Traiserdinger/Custom-PX4-Flight-Controller/Hardware/Project Outputs for Trung Flight Controller/Net Status - Trung PX4 Flight Controller PCB.html

Altium customize

# Net Status Report

Date: | | 16/08/2026
Time: | | 5:39:50 CH
Elapsed Time: | | 00:00:00
Filename: | | C:\Users\Public\Documents\Altium\Projects\PX4 Flight Controller\Trung PX4 Flight Controller PCB.PcbDoc
Units: | | mmmils

Nets | Layer | Length
+3.3 | Signal Layers Only | 237.2458mm
+5 | Signal Layers Only | 95.8072mm
5V_SERVO | Signal Layers Only | 0mm
AUX_OUT_1 | Signal Layers Only | 0mm
AUX_OUT_2 | Signal Layers Only | 0mm
AUX_OUT_3 | Signal Layers Only | 0mm
AUX_OUT_4 | Signal Layers Only | 0mm
AUX_PWM_1 | Signal Layers Only | 10.7949mm
AUX_PWM_2 | Signal Layers Only | 8.8497mm
AUX_PWM_3 | Signal Layers Only | 6.9821mm
AUX_PWM_4 | Signal Layers Only | 6.4275mm
BARO1_CS | Signal Layers Only | 28.2336mm
BARO2_CS | Signal Layers Only | 19.96mm
BATT_CURRENT_SENS | Signal Layers Only | 0mm
BATT_VOLTAGE_SENS | Signal Layers Only | 0mm
BUZZER | Signal Layers Only | 82.9503mm
CAN1_RX | Signal Layers Only | 6.7935mm
CAN1_TX | Signal Layers Only | 3.9007mm
CAN2_TX | Signal Layers Only | 0mm
CAN_N | Signal Layers Only | 80.7832mm
CAN_P | Signal Layers Only | 80.543mm
FMU-SWCLK | Signal Layers Only | 152.9089mm
FMU-SWDIO | Signal Layers Only | 130.2979mm
FMU_USART6_RX | Signal Layers Only | 17.5303mm
FMU_USART6_TX | Signal Layers Only | 0mm
FPGA_CS | Signal Layers Only | 46.5756mm
FPGA_SPI_MISO | Signal Layers Only | 51.7681mm
FPGA_SPI_MOSI | Signal Layers Only | 48.0146mm
FPGA_SPI_SCK | Signal Layers Only | 55.9898mm
FRAM_CS | Signal Layers Only | 10.7605mm
GND | Signal Layers Only | 0mm
I2C1_SCL | Signal Layers Only | 44.911mm
I2C1_SDA | Signal Layers Only | 44.6991mm
I2C2_SCL | Signal Layers Only | 65.9293mm
I2C2_SDA | Signal Layers Only | 62.0535mm
IBUS_SIGNAL | Signal Layers Only | 7.2247mm
IMU1_CS | Signal Layers Only | 11.66mm
IMU1_DRDY | Signal Layers Only | 41.7434mm
IMU2_CS | Signal Layers Only | 39.8278mm
IMU2_DRDY | Signal Layers Only | 40.4862mm
LED1_STATUS | Signal Layers Only | 50.241mm
LED2_STATUS | Signal Layers Only | 56.7658mm
MOTOR_1 | Signal Layers Only | 22.9411mm
MOTOR_2 | Signal Layers Only | 22.2621mm
MOTOR_3 | Signal Layers Only | 19.4496mm
MOTOR_4 | Signal Layers Only | 16.6951mm
NetC29_2 | Signal Layers Only | 1.9167mm
NetC39_2 | Signal Layers Only | 6.6173mm
NetC40_2 | Signal Layers Only | 2.2543mm
NetC5_2 | Signal Layers Only | 5.5239mm
NetC6_2 | Signal Layers Only | 4.3707mm
NetC9_1 | Signal Layers Only | 1.9088mm
NetD1_A | Signal Layers Only | 1.6719mm
NetD2_A | Signal Layers Only | 1.6095mm
NetD4_C | Signal Layers Only | 1.6189mm
NetD6_C | Signal Layers Only | 1.6178mm
NetD7_C | Signal Layers Only | 1.642mm
NetJ1_A5 | Signal Layers Only | 4.2391mm
NetJ1_B5 | Signal Layers Only | 4.2736mm
NetJ2_P1 | Signal Layers Only | 5.2159mm
NetP1_1 | Signal Layers Only | 9.8137mm
NetP1_2 | Signal Layers Only | 7.2868mm
NetP1_3 | Signal Layers Only | 6.872mm
NetP1_5 | Signal Layers Only | 6.2762mm
NetP1_7 | Signal Layers Only | 7.3289mm
NetP1_8 | Signal Layers Only | 10.278mm
NetQ1_1 | Signal Layers Only | 1.8466mm
NetR1_1 | Signal Layers Only | 16.2939mm
NetR33_1 | Signal Layers Only | 2.2852mm
OTG_FS_N | Signal Layers Only | 18.1629mm
OTG_FS_P | Signal Layers Only | 16.5977mm
OUT_1 | Signal Layers Only | 44.5039mm
OUT_2 | Signal Layers Only | 55.2337mm
OUT_3 | Signal Layers Only | 51.2503mm
OUT_4 | Signal Layers Only | 38.8108mm
OUT_5 | Signal Layers Only | 0mm
OUT_6 | Signal Layers Only | 0mm
PB2-BOOT1 | Signal Layers Only | 4.2311mm
PC14 | Signal Layers Only | 14.3922mm
PC15 | Signal Layers Only | 10.0584mm
PH0 | Signal Layers Only | 2.6934mm
PH1 | Signal Layers Only | 3.5003mm
RESET | Signal Layers Only | 69.2586mm
SAFETY_LED | Signal Layers Only | 56.8271mm
SAFETY_SWITCH | Signal Layers Only | 46.5075mm
SDMMC_CLK | Signal Layers Only | 75.1902mm
SDMMC_CMD | Signal Layers Only | 116.0412mm
SDMMC_D0 | Signal Layers Only | 62.3294mm
SDMMC_D1 | Signal Layers Only | 65.6951mm
SDMMC_D2 | Signal Layers Only | 79.0215mm
SDMMC_D3 | Signal Layers Only | 77.6269mm
SD_CD | Signal Layers Only | 2.4243mm
SPI1_MISO | Signal Layers Only | 37.963mm
SPI1_MOSI | Signal Layers Only | 60.3726mm
SPI1_SCK | Signal Layers Only | 61.905mm
SPI2_MISO | Signal Layers Only | 8.4154mm
SPI2_MOSI | Signal Layers Only | 13.3209mm
SPI2_SCK | Signal Layers Only | 16.4157mm
SPI3_MISO | Signal Layers Only | 2.7848mm
SPI3_MOSI | Signal Layers Only | 2.7338mm
SPI3_SCK | Signal Layers Only | 14.4717mm
UART4_RX | Signal Layers Only | 28.0332mm
UART4_TX | Signal Layers Only | 36.4451mm
UART7_RX | Signal Layers Only | 32.0728mm
UART7_TX | Signal Layers Only | 42.638mm
UART8_RX | Signal Layers Only | 96.581mm
UART8_TX | Signal Layers Only | 87.9697mm
USART2_RX | Signal Layers Only | 0mm
USART2_TX | Signal Layers Only | 0mm
USART3_RX | Signal Layers Only | 0mm
USART3_TX | Signal Layers Only | 0mm
USB_CONN_N | Signal Layers Only | 10.9234mm
USB_CONN_P | Signal Layers Only | 14.1718mm
VADC | Signal Layers Only | 9.8255mm
VBAT_IN | Signal Layers Only | 88.3314mm
VBUS | Signal Layers Only | 58.5316mm
VCC_3V3_SENS | Signal Layers Only | 88.0643mm

Back to top
