Traiserdinger/Custom-PX4-Flight-Controller/Docs/images/pcb_bot.jpg

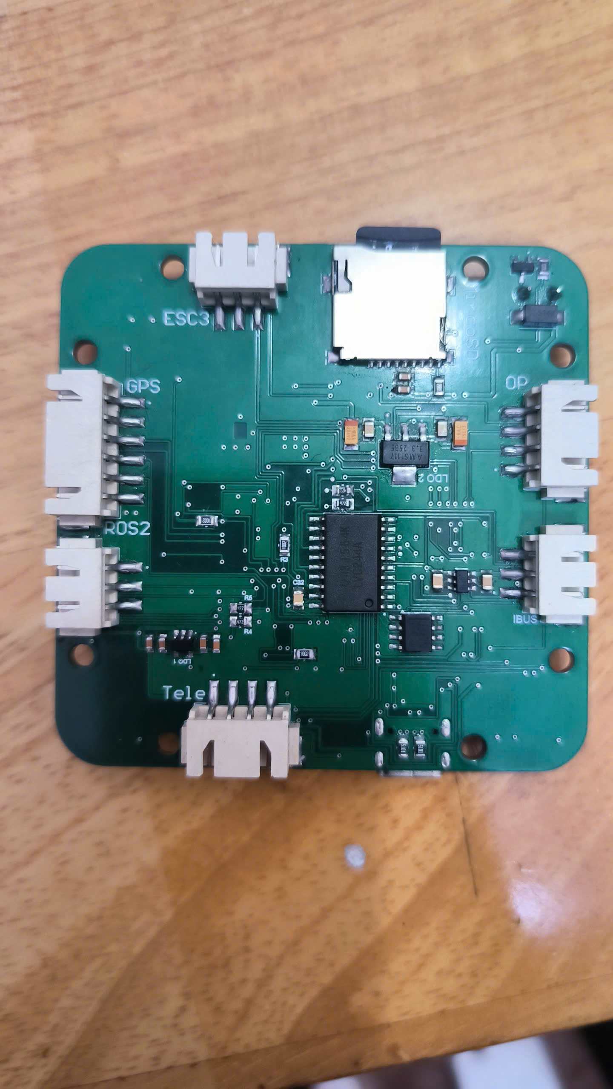
Docs/images/pcb_bot.jpg
