Traiserdinger/Custom-PX4-Flight-Controller/Docs/images/pcb_top.jpg

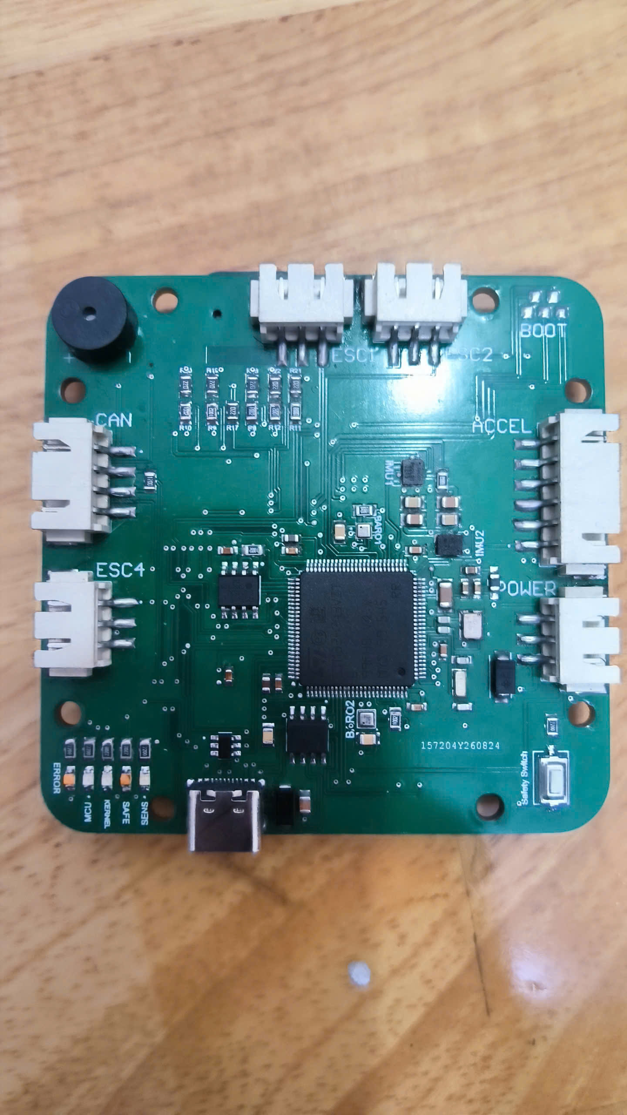
Docs/images/pcb_top.jpg
