Traiserdinger/Custom-PX4-Flight-Controller/Hardware/Project Outputs for Trung Flight Controller/Trung_Flight_Controller_BOM.xlsx

Comment | Description | Designator | Kích thước | LibRef | Quantity | Tình trạng | Giá thành | Nhà cung cấp
FPGA Accel | Đầu nối JST XH 6 chân, hàn SMD, góc vuông | ACCEL | Pitch 2.5mm, 6 chân | S6B-XH-SM4-TB | 1 | Chưa tìm được
BMP390L | Cảm biến áp suất tuyệt đối 30–125kPa, dùng đo độ cao | BARO1 | 10-WFLGA, ~2.0 x 2.0 x 0.8mm | BMP390L | 1 | Chưa tìm được
BMP581 | Cảm biến áp suất khí quyển 24-bit, công suất thấp, độ nhiễu thấp, dùng đo độ cao | BARO2 | LGA, ~2.0 x 2.0 x 0.75mm | BMP581 | 1 | Chưa tìm được
Pad Connector | Chân pad hàn trên PCB dùng để boot | BOOT | Pad hàn trên PCB | Pad Connector | 1 | Chưa tìm được
100nF | Tụ gốm SMD X7R ±10%, 50V | C1, C2, C3, C4, C7, C10, C20, C21, C22, C23, C30 | 0603 (1.6 x 0.8mm) | GRM188R71H104KA93D | 11 | Chưa tìm được
2.2uF | Tụ gốm SMD X7R ±10%, 50V | C5, C6 | 0603 (1.6 x 0.8mm) | GRM188R71H104KA93D | 2 | Chưa tìm được
100nF | Tụ gốm SMD X7R ±10%, 100V | C8 | 1206 (3.2 x 1.6mm) | 12061C104KAT2A | 1 | Chưa tìm được
1uF | Tụ gốm SMD X7R ±10%, 50V | C9, C11, C28, C31 | 0603 (1.6 x 0.8mm) | GRM188R71H104KA93D | 4 | Chưa tìm được
10pF | Tụ gốm SMD X7R ±10%, 50V | C12, C13 | 0603 (1.6 x 0.8mm) | GRM188R71H104KA93D | 2 | Chưa tìm được
100nF | Tụ gốm SMD X7R ±10%, 50V | C14, C15, C16, C18, C25, C26, C32, C33, C34, C36 | 0805 (2.0 x 1.2mm) | GRM21BR71H104KA01L | 10 | Chưa tìm được
2.2uF | Tụ gốm SMD X7R 2.2µF ±10%, 25V | C17, C19 | 0805 (2.0 x 1.2mm) | 08053C225K4Z2A | 2 | Chưa tìm được
10uF | Tụ tantalum 10µF, 10V, ESR 3.8Ω | C24, C27 | 1206 (3.2 x 1.6mm) | T491A106K010AT7280 | 2 | Chưa tìm được
22nF | Tụ gốm SMD X7R ±10%, 50V | C29 | 0603 (1.6 x 0.8mm) | GRM188R71H104KA93D | 1 | Chưa tìm được
10uF | Tụ gốm SMD X5R 10µF ±10%, 16V | C35 | 0805 (2.0 x 1.2mm) | GRM21BR61C106KE15L | 1 | Chưa tìm được
8pF | Tụ gốm SMD C0G/NP0 8pF ±0.5pF, 50V | C39, C40 | 0402 (1.0 x 0.5mm) | C1005C0G1H080D050BA | 2 | Chưa tìm được
CAN | Đầu nối JST XH 4 chân, hàn SMD, góc vuông | CAN | Pitch 2.5mm, 4 chân | S4B-XH-SM4-TB | 1 | Chưa tìm được
SS34L | Diode Schottky 3A, 40V, dạng phẳng (planar) | D3 | SOD-123FL, ~3.6 x 1.8mm | SS34L | 1 | Chưa tìm được
SMAJ5.0A | Diode bảo vệ TVS 5.0V, 400W, 1 chiều | D5 | SMA (DO-214AC), ~5.0 x 2.6mm | SMAJ5.0A | 1 | Chưa tìm được
Error LED | LED đỏ 633nm, 2.1V | ERROR | 0805 (2.0 x 1.25mm) | 5990110007F | 1 | Chưa tìm được
ESC1 | Đầu nối JST XH 3 chân, hàn SMD, góc vuông | ESC1 | Pitch 2.5mm, 3 chân | S3B-XH-SM3-TB | 1 | Chưa tìm được
ESC2 | Đầu nối JST XH 3 chân, hàn SMD, góc vuông | ESC2 | Pitch 2.5mm, 3 chân | S3B-XH-SM3-TB | 1 | Chưa tìm được
ESC3 | Đầu nối JST XH 3 chân, hàn SMD, góc vuông | ESC3 | Pitch 2.5mm, 3 chân | S3B-XH-SM3-TB | 1 | Chưa tìm được
ESC4 | Đầu nối JST XH 3 chân, hàn SMD, góc vuông | ESC4 | Pitch 2.5mm, 3 chân | S3B-XH-SM3-TB | 1 | Chưa tìm được
600 | Cuộn ferrite bead 560Ω | FB1 | 0805 (2.0 x 1.2mm) | WE-CBA_0805 | 1 | Chưa tìm được
GPS | Đầu nối JST XH 6 chân, hàn SMD, góc vuông | GPS | Pitch 2.5mm, 6 chân | S6B-XH-SM4-TB | 1 | Chưa tìm được
iA6B i-Bus | Đầu nối JST XH 3 chân, hàn SMD, góc vuông | IBUS | Pitch 2.5mm, 3 chân | S3B-XH-SM3-TB | 1 | Chưa tìm được
ICM-42670-P | Cảm biến IMU 6 trục (gia tốc + con quay hồi chuyển) | IMU1 | QFN, xem datasheet | ICM-42670-P | 1 | Chưa tìm được
ICM-42688-P | Cảm biến IMU 6 trục (gia tốc + con quay hồi chuyển) | IMU2 | QFN-14, ~2.5 x 3.0mm | ICM-42688-P | 1 | Chưa tìm được
USB Type-C 16 Pin SMD | Đầu nối USB Type-C, 16 chân, hàn SMD | J1 | 16 chân, SMD (xem datasheet Amphenol) | 10155435-00011LF | 1 | Chưa tìm được
SS14 | Diode Schottky 1A, 40V | J2 | SMA (DO-214AC), ~4.3 x 2.6mm | SS14 | 1 | Chưa tìm được
Kernel LED | LED đỏ 633nm, 2.1V | KERNEL | 0805 (2.0 x 1.25mm) | 5990110007F | 1 | Chưa tìm được
RT9193-33GB | IC nguồn LDO 3.3V, 300mA | LDO 1 | TSOT-23-5, ~2.9 x 1.6mm | RT9193-33GB | 1 | Chưa tìm được
AMS1117-3.3 | IC nguồn LDO 3.3V, 1A | LDO 2 | SOT-223-3, ~6.5 x 3.5mm | AMS1117-3.3 | 1 | Chưa tìm được
Passive Buzzer 9mm | Loa buzzer thụ động, 3Vpp, 20Ω, 86dB | LS1 | Ø9mm, cao ~2.7mm | AT-0927-TT-2-R | 1 | Chưa tìm được
MCU LED | LED đỏ 633nm, 2.1V | MCU | 0805 (2.0 x 1.25mm) | 5990110007F | 1 | Chưa tìm được
ST-TF-003A | Khe cắm thẻ nhớ Micro SD | MircoSD | Xem datasheet ST-TF-003A | ST-TF-003A | 1 | Chưa tìm được
MTF-02P | Đầu nối JST XH 4 chân, hàn SMD, góc vuông | OP | Pitch 2.5mm, 4 chân | S4B-XH-SM4-TB | 1 | Chưa tìm được
Power Input | Đầu nối JST XH 3 chân, hàn SMD, góc vuông | POWER | Pitch 2.5mm, 3 chân | S3B-XH-SM3-TB | 1 | Chưa tìm được
MMBT3904 | Transistor NPN, 40V, 200mA, 0.35W | Q1 | SOT-23, ~2.9 x 1.3mm | MMBT3904 | 1 | Chưa tìm được
10K | Điện trở dán ±1%, 1/8W | R1, R2, R3, R8, R9, R10, R11, R12, R13, R14, R15, R16, R23 | 0805 (2.0 x 1.25mm) | RC0805FR-075K1L | 13 | Chưa tìm được
4K7 | Điện trở dán ±1%, 1/8W | R4, R5, R6, R7 | 0805 (2.0 x 1.25mm) | RC0805FR-075K1L | 4 | Chưa tìm được
22 | Điện trở dán ±1%, 1/8W | R17, R18, R19, R20, R21, R22 | 0805 (2.0 x 1.25mm) | RC0805FR-075K1L | 6 | Chưa tìm được
220 | Điện trở dán ±1%, 1/8W | R24, R25, R33, R34, R35, R36 | 0805 (2.0 x 1.25mm) | RC0805FR-075K1L | 6 | Chưa tìm được
5.1K | Điện trở dán ±1%, 1/8W | R26, R27 | 0805 (2.0 x 1.25mm) | RC0805FR-075K1L | 2 | Chưa tìm được
1K | Điện trở dán ±1%, 1/8W | R28 | 0805 (2.0 x 1.25mm) | RC0805FR-075K1L | 1 | Chưa tìm được
120 | Điện trở dán ±1%, 1/8W | R32 | 0805 (2.0 x 1.25mm) | RC0805FR-075K1L | 1 | Chưa tìm được
ROS2 uXRCE-DDS | Đầu nối JST XH 3 chân, hàn SMD, góc vuông | ROS2 | Pitch 2.5mm, 3 chân | S3B-XH-SM3-TB | 1 | Chưa tìm được
Safety LED | LED đỏ 633nm, 2.1V | SAFE | 0805 (2.0 x 1.25mm) | 5990110007F | 1 | Chưa tìm được
Safety ARM | Công tắc an toàn IP67, dạng nhấn, SMT, lực nhấn 160gf | Safety Switch | 6.2 x 4.1 x 2.5mm (cao) | 434781025816 | 1 | Chưa tìm được
Sensor LED | LED đỏ 633nm, 2.1V | SENS | 0805 (2.0 x 1.25mm) | 5990110007F | 1 | Chưa tìm được
Telemetry | Đầu nối JST XH 4 chân, hàn SMD, góc vuông | Tele | Pitch 2.5mm, 4 chân | S4B-XH-SM4-TB | 1 | Chưa tìm được
STM32H743VIT6 | Vi điều khiển ARM Cortex-M7 480MHz, Flash 2MB | U1 | LQFP-100, 14 x 14mm | STM32H743VIT6 | 1 | Chưa tìm được
INA219AIDR | IC đo dòng điện/điện áp qua I2C, 26V, 12-bit | U5 | SOIC-8, ~4.9 x 3.9mm | INA219AIDR | 1 | Chưa tìm được
FM25V05-G | IC bộ nhớ F-RAM 4Kbit (512x8), giao tiếp SPI | U6 | SOIC-8, ~4.9 x 3.9mm | FM25V05-G | 1 | Chưa tìm được
SN74LVC244ADWR | IC đệm 8 kênh, 3 trạng thái, 1.65V–3.6V | U9 | SOIC-20 (thân rộng) | SN74LVC244ADWR | 1 | Chưa tìm được
SN74LVC1T45DBVR | IC chuyển mức điện áp 1 bit, 2 nguồn cấp, 3 trạng thái | U10 | SOT-23-6, ~2.8 x 1.6mm | SN74LVC1T45DBVR | 1 | Chưa tìm được
USBLC6-2SC6 | Diode bảo vệ TVS cho USB, 17V, 5A | U11 | SOT-23-6, ~2.8 x 1.6mm | USBLC6-2SC6 | 1 | Chưa tìm được
SN65HVD230DR | IC giao tiếp CAN transceiver 3.3V, có chế độ standby | U12 | SOIC-8, ~4.9 x 3.9mm | SN65HVD230DR | 1 | Chưa tìm được
Crystal 24MHz | Thạch anh 24MHz ±30ppm, tải 10pF | Y1 | 4-SMD, ~3.2 x 2.5mm | ABM8G-24.000MHZ-B4Y-T | 1 | Chưa tìm được
Crystal 32.768kHz | Thạch anh tần số thấp 32.768kHz | Y2 | SMD nhỏ, xem datasheet | CC7V-T1A-32.768KHZ-7PF-100PPM-TA-QC | 1 | Chưa tìm được
