Traiserdinger/Custom-PX4-Flight-Controller/Mechanical/3D Printed/F450-MODEL/Li-Ion 6S2P 8400mAh.STEP

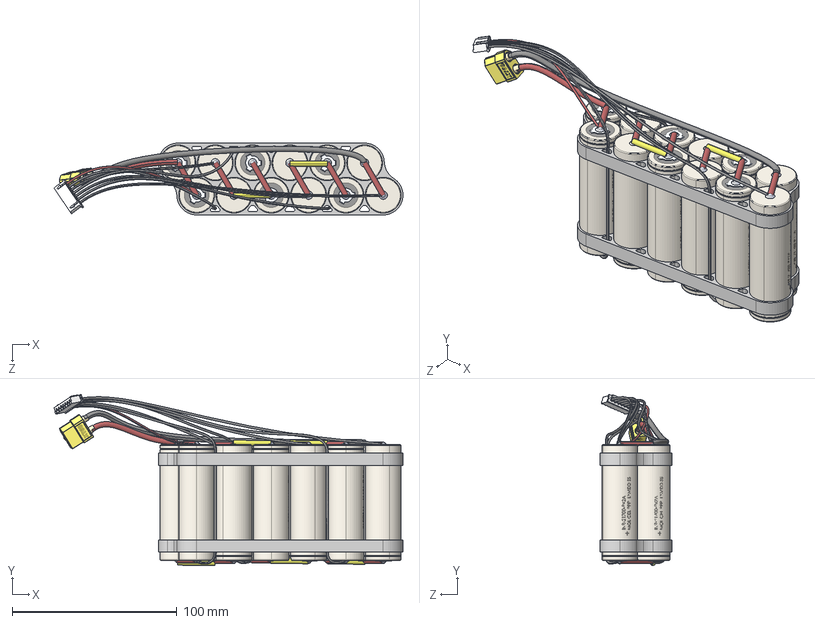
[picture p4: CAD file, 2026-11-06]
Mechanical/3D Printed/F450-MODEL/Li-Ion 6S2P 8400mAh.STEP
211.8 x 103.9 x 43.6 mm
MOLICEL INR-21700-P42A_Défaut x 12
6S2P_6S2P x 2
Parallel Connector^Assembly x 12
Series Connector^Assembly x 5
XT60 Female Connector_XT60 Female Connector
XT60 Pos^Assembly
XT60 Neg^Assembly
JST-xH 7pin Female
Balance Cables^Assembly
