Traiserdinger/Custom-PX4-Flight-Controller/Mechanical/3D Printed/files/djigear2.stl

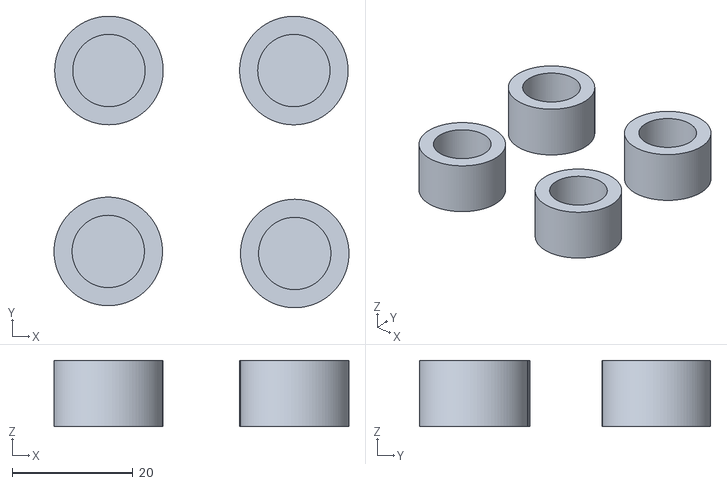
[picture p5: CAD file, 2026-11-06]
Mechanical/3D Printed/files/djigear2.stl
48.9 x 48.4 x 11.0
