Traiserdinger/Custom-PX4-Flight-Controller/Mechanical/3D Printed/ESC1001_Halterung-REMIX.stl

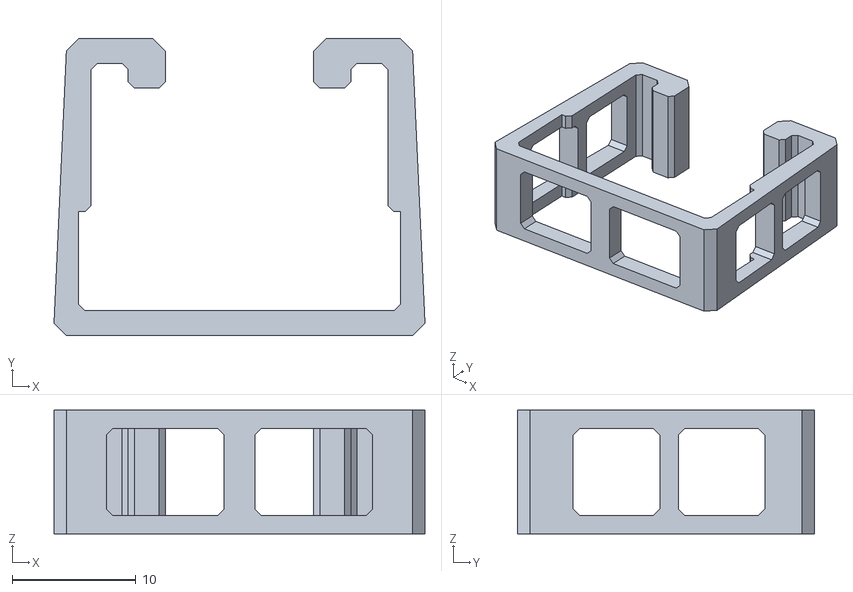
[picture p6: CAD file, 2026-11-06]
Mechanical/3D Printed/ESC1001_Halterung-REMIX.stl
30.0 x 24.0 x 10.0
