Traiserdinger/Custom-PX4-Flight-Controller/Mechanical/3D Printed/F450-MODEL/Drone Case.stl

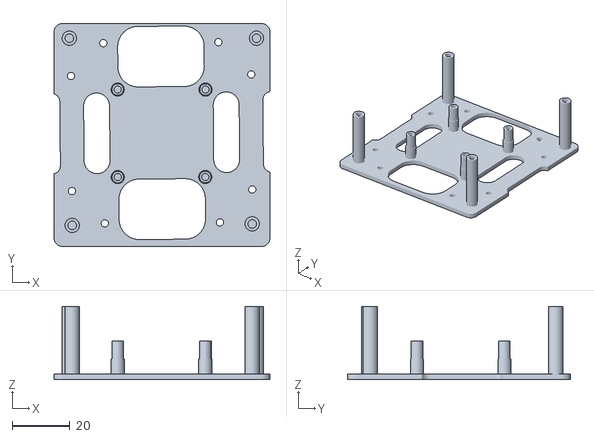
[picture p7: CAD file, 2026-11-06]
Mechanical/3D Printed/F450-MODEL/Drone Case.stl
75.0 x 77.5 x 25.5
