Traiserdinger/Custom-PX4-Flight-Controller/Mechanical/3D Printed/files/F450_Receptor_-_Antena_lateral.stl

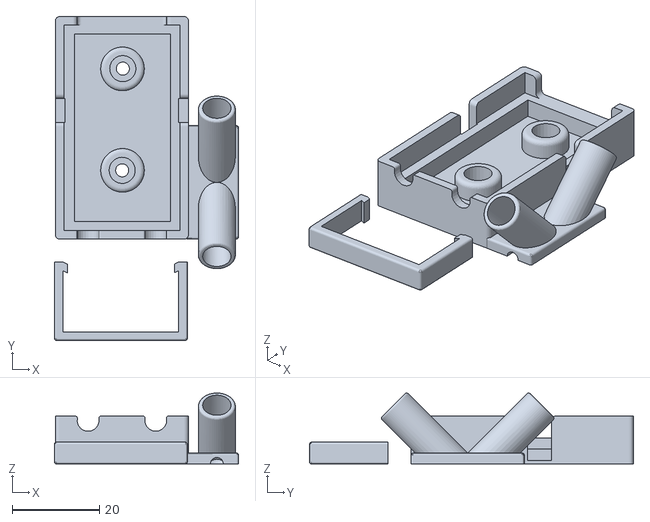
[picture p8: CAD file, 2026-11-06]
Mechanical/3D Printed/files/F450_Receptor_-_Antena_lateral.stl
42.2 x 74.2 x 16.3
