Traiserdinger/Custom-PX4-Flight-Controller/Mechanical/3D Printed/Drone Case.stl

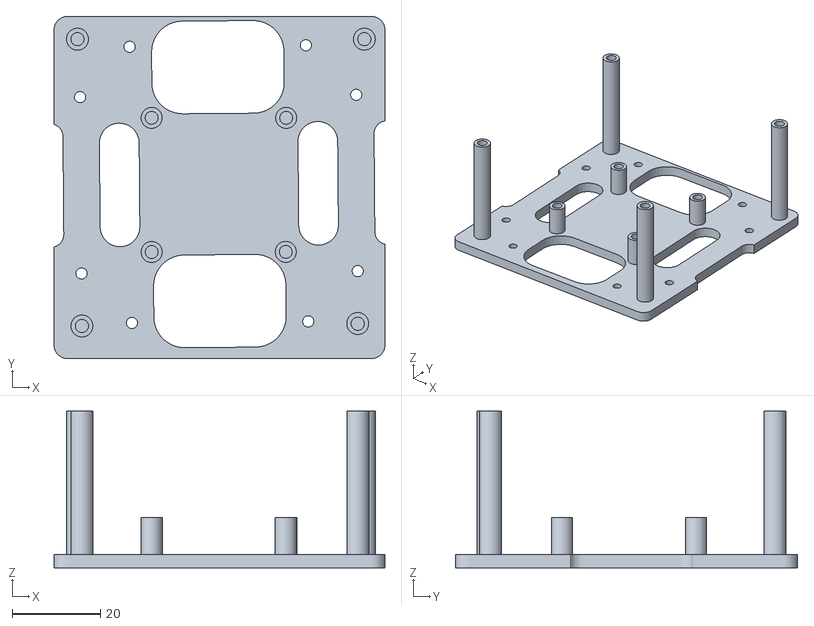
[picture p9: CAD file, 2026-11-06]
Mechanical/3D Printed/Drone Case.stl
75.0 x 77.5 x 35.5
