Traiserdinger/Custom-PX4-Flight-Controller/Mechanical/3D Printed/F450-MODEL/BOTTOM.stl

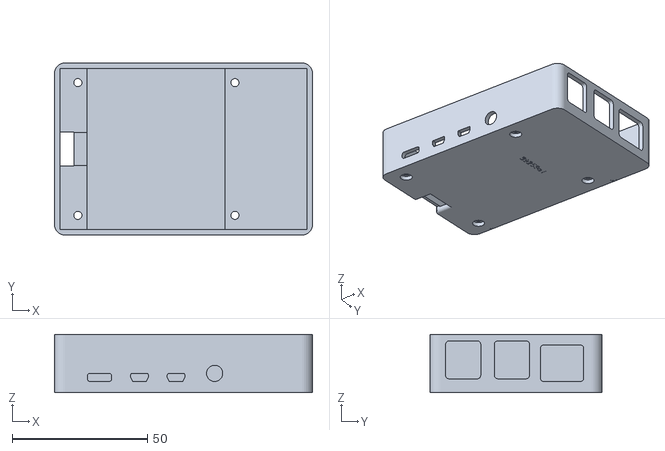
[picture p10: CAD file, 2026-11-06]
Mechanical/3D Printed/F450-MODEL/BOTTOM.stl
95.2 x 63.5 x 21.6
