Traiserdinger/Custom-PX4-Flight-Controller/Mechanical/3D Printed/files/copter_stopav3.stl

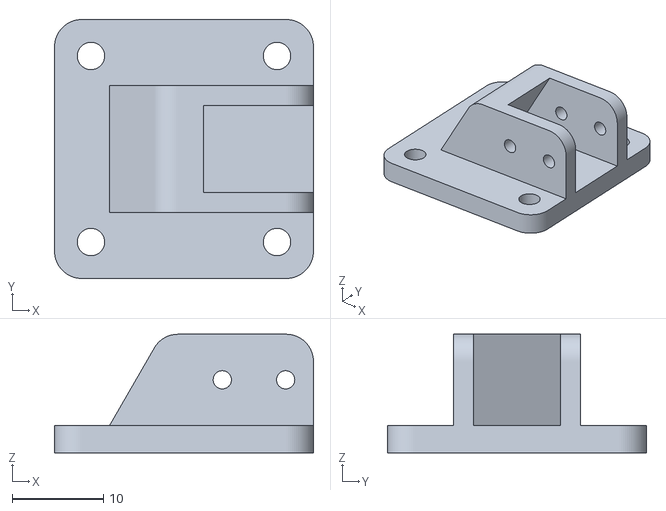
[picture p11: CAD file, 2026-11-06]
Mechanical/3D Printed/files/copter_stopav3.stl
28.4 x 28.4 x 13.0
