Traiserdinger/Custom-PX4-Flight-Controller/Mechanical/3D Printed/base.stl

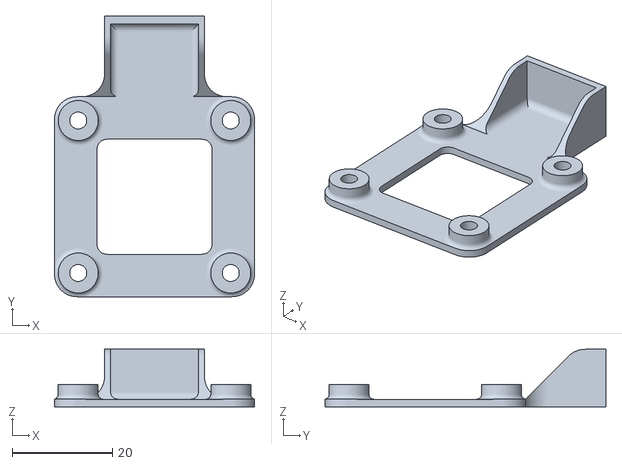
[picture p12: CAD file, 2026-11-06]
Mechanical/3D Printed/base.stl
40.0 x 56.1 x 11.5
