Traiserdinger/Custom-PX4-Flight-Controller/Mechanical/3D Printed/F450-MODEL/TOP.stl

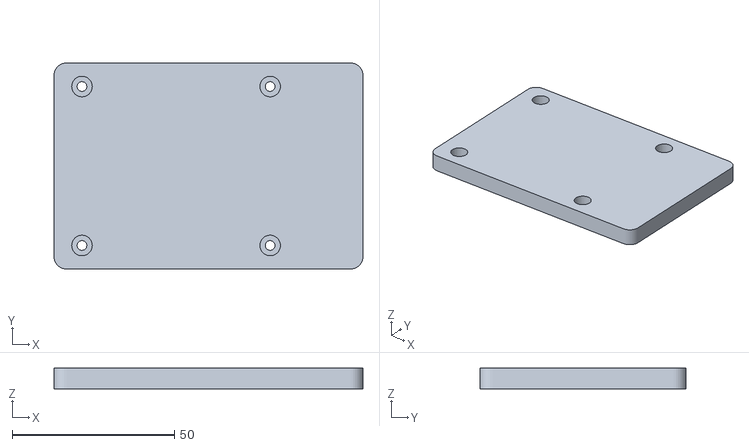
[picture p13: CAD file, 2026-11-06]
Mechanical/3D Printed/F450-MODEL/TOP.stl
95.2 x 63.5 x 6.35
