Traiserdinger/Custom-PX4-Flight-Controller/Mechanical/3D Printed/files/djigear.stl

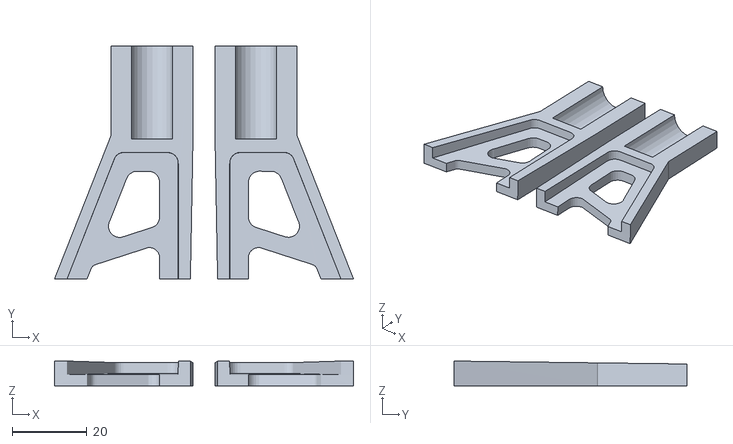
[picture p14: CAD file, 2026-11-06]
Mechanical/3D Printed/files/djigear.stl
79.8 x 62.3 x 6.65
