Traiserdinger/Custom-PX4-Flight-Controller/Mechanical/3D Printed/F450-MODEL/FEICHAO BE4108 380KV.stp

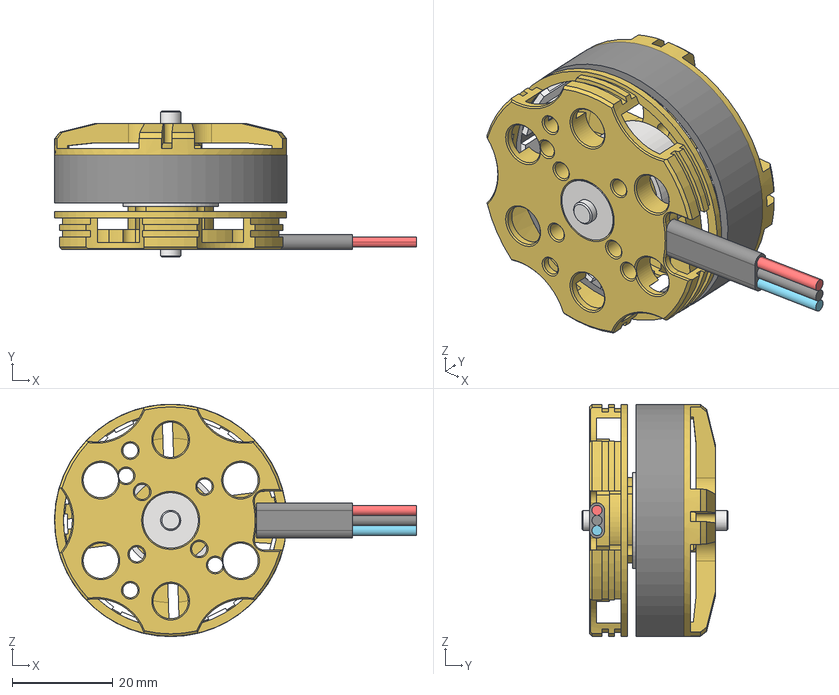
[picture p15: CAD file, 2026-11-06]
Mechanical/3D Printed/F450-MODEL/FEICHAO BE4108 380KV.stp
71.8 x 29.0 x 46.1 mm
BASE
METAL RING
SHAFT
CAN
BEARING x 2
CABLE
