Traiserdinger/Custom-PX4-Flight-Controller/Mechanical/3D Printed/files/copter_nogav3.stl

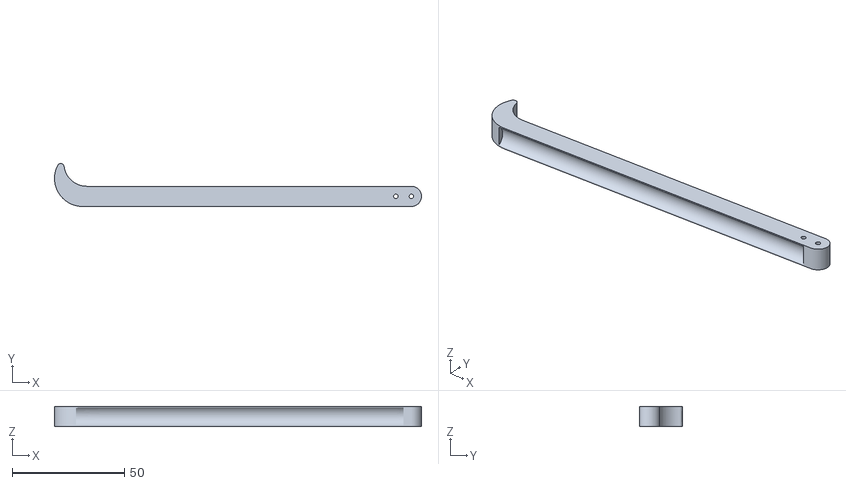
[picture p16: CAD file, 2026-11-06]
Mechanical/3D Printed/files/copter_nogav3.stl
163.6 x 19.1 x 9.00
