Traiserdinger/Custom-PX4-Flight-Controller/Mechanical/3D Printed/M8P-ZHIJIA-TUOPAN-C1.stl

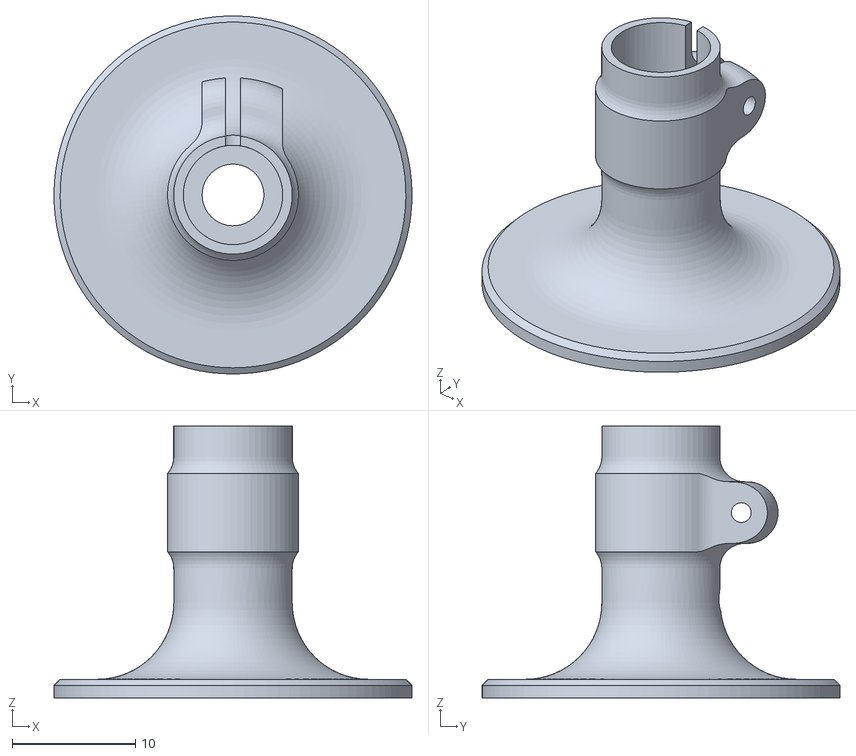
[picture p17: CAD file, 2026-11-06]
Mechanical/3D Printed/M8P-ZHIJIA-TUOPAN-C1.stl
29.0 x 29.0 x 22.0
