Traiserdinger/Custom-PX4-Flight-Controller/Mechanical/3D Printed/F450-MODEL/Raspberry Pi 4 casing.step

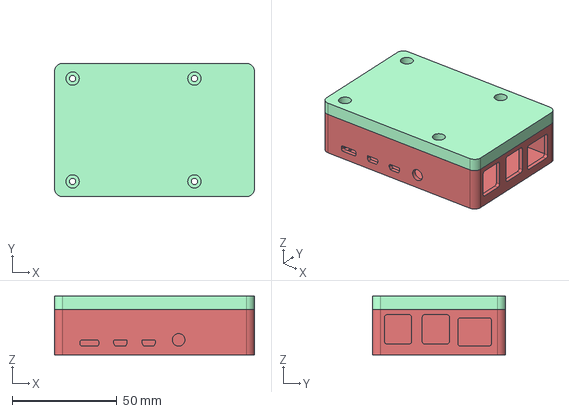
[picture p18: CAD file, 2026-11-06]
Mechanical/3D Printed/F450-MODEL/Raspberry Pi 4 casing.step
95.2 x 63.5 x 27.9 mm
TOP
BOTTOM
