Traiserdinger/Custom-PX4-Flight-Controller/Mechanical/3D Printed/RTK-ZHIJIA-ZUO-8-C1.stl

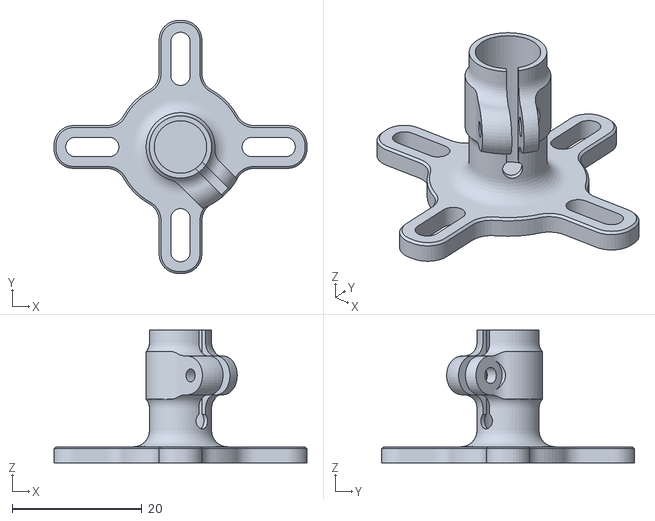
[picture p19: CAD file, 2026-11-06]
Mechanical/3D Printed/RTK-ZHIJIA-ZUO-8-C1.stl
39.0 x 39.0 x 20.5
