Traiserdinger/Custom-PX4-Flight-Controller/Mechanical/3D Printed/F450-MODEL/Top Case Flight Control.stl

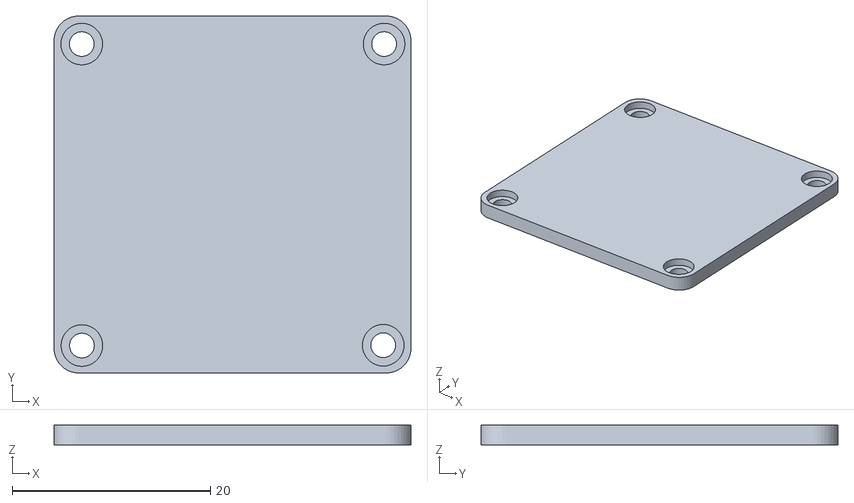
[picture p20: CAD file, 2026-11-06]
Mechanical/3D Printed/F450-MODEL/Top Case Flight Control.stl
36.0 x 36.0 x 2.00
