Traiserdinger/Custom-PX4-Flight-Controller/Mechanical/3D Printed/VoMachPDB.stl

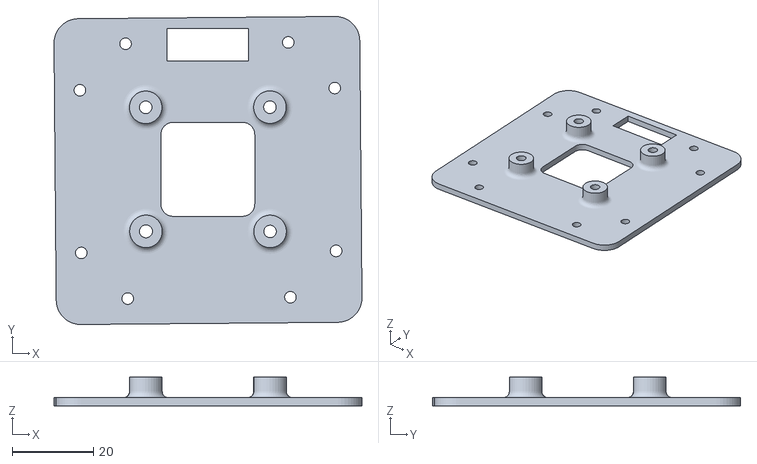
[picture p21: CAD file, 2026-11-06]
Mechanical/3D Printed/VoMachPDB.stl
75.6 x 75.6 x 7.00
