Traiserdinger/Custom-PX4-Flight-Controller/Mechanical/3D Printed/F450-MODEL/Raspberry Pi 4 Model B.stp

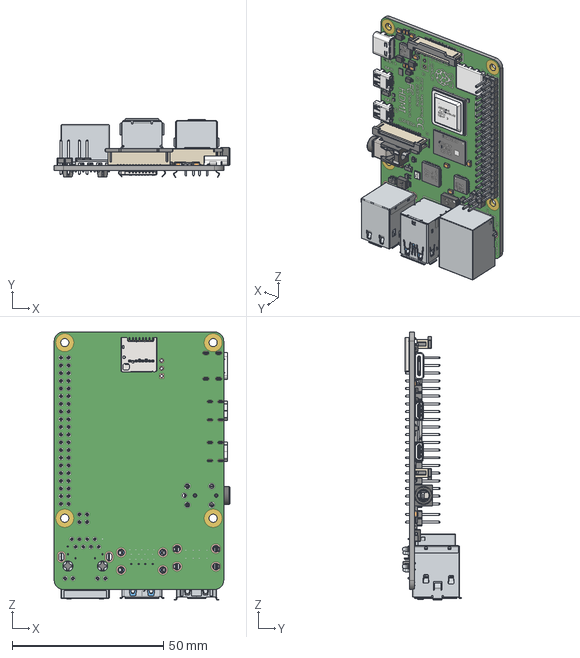
[picture p22: CAD file, 2026-11-06]
Mechanical/3D Printed/F450-MODEL/Raspberry Pi 4 Model B.stp
58.0 x 19.6 x 88.5 mm
