Traiserdinger/Custom-PX4-Flight-Controller/Mechanical/3D Printed/GUAN-RTK-JIA-8.stl

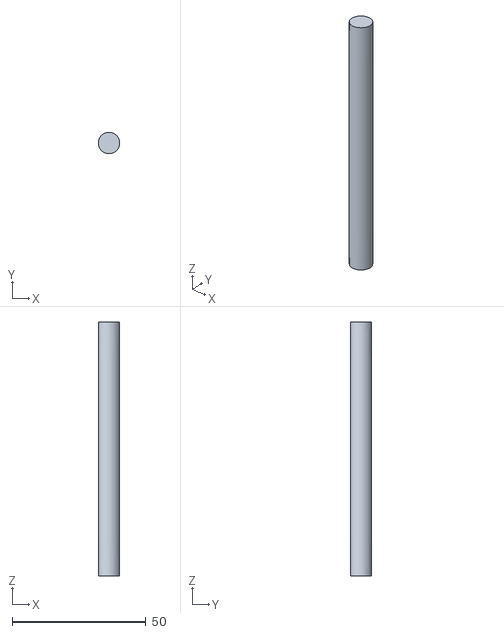
[picture p23: CAD file, 2026-11-06]
Mechanical/3D Printed/GUAN-RTK-JIA-8.stl
8.00 x 8.00 x 95.0
