Traiserdinger/Custom-PX4-Flight-Controller/Mechanical/3D Printed/F450-MODEL/Raspberry Pi 4 Hold.stl

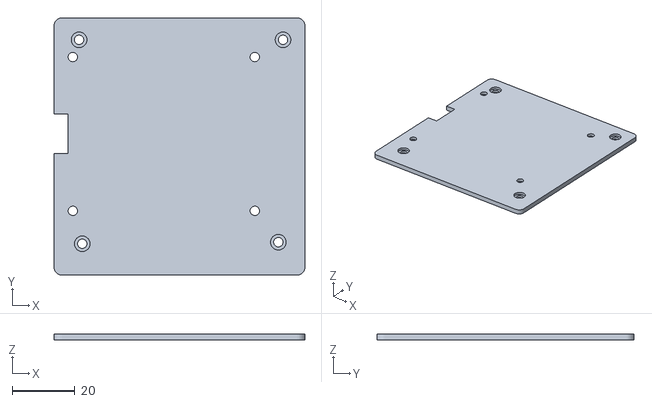
[picture p24: CAD file, 2026-11-06]
Mechanical/3D Printed/F450-MODEL/Raspberry Pi 4 Hold.stl
80.0 x 82.0 x 2.00
