Traiserdinger/Custom-PX4-Flight-Controller/Mechanical/3D Printed/MTF-02P Case.stl

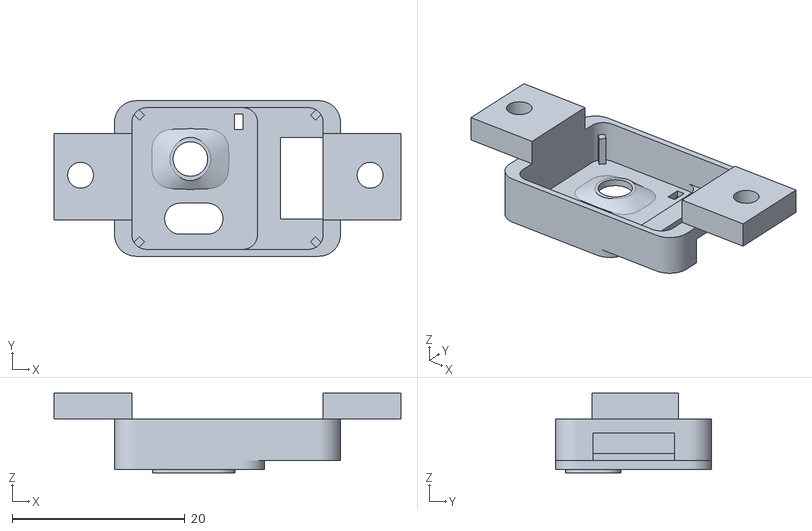
[picture p25: CAD file, 2026-11-06]
Mechanical/3D Printed/MTF-02P Case.stl
40.2 x 18.0 x 9.20
