Traiserdinger/Custom-PX4-Flight-Controller/Mechanical/3D Printed/Holding Optical Flow.stl

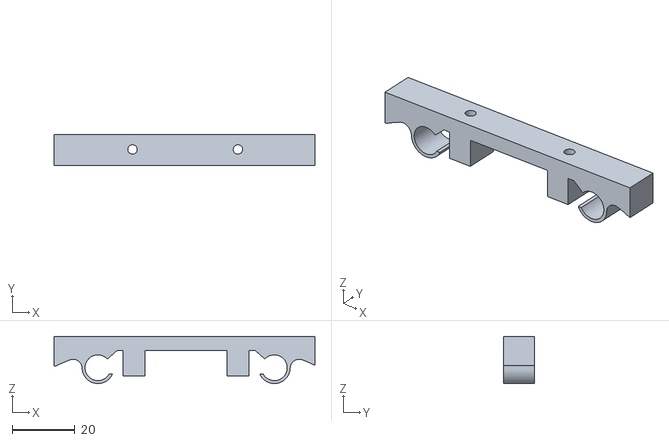
[picture p26: CAD file, 2026-11-06]
Mechanical/3D Printed/Holding Optical Flow.stl
83.0 x 10.0 x 15.0
