Traiserdinger/Custom-PX4-Flight-Controller/Mechanical/3D Printed/Holding Gripper.stl

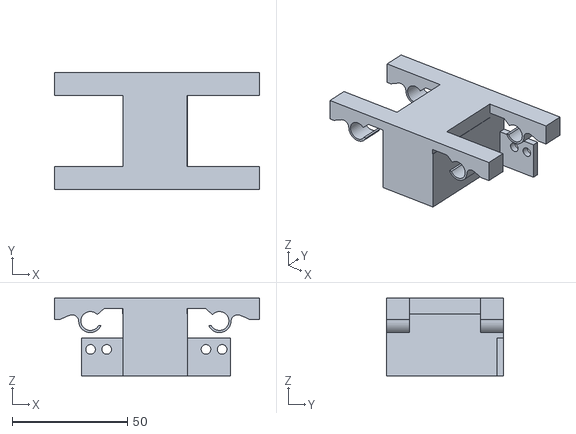
[picture p27: CAD file, 2026-11-06]
Mechanical/3D Printed/Holding Gripper.stl
89.0 x 51.0 x 33.8
