Traiserdinger/Custom-PX4-Flight-Controller/Mechanical/3D Printed/HoldingRX.stl

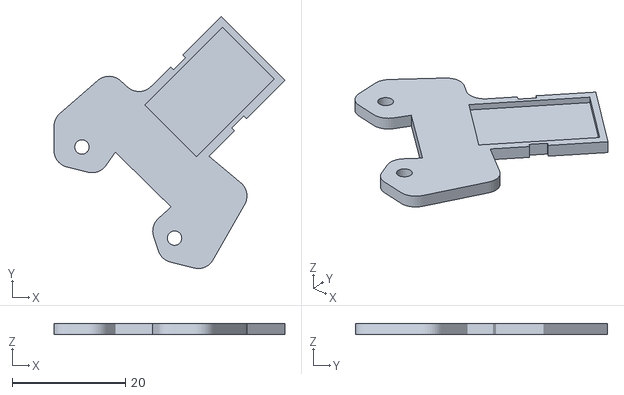
[picture p28: CAD file, 2026-11-06]
Mechanical/3D Printed/HoldingRX.stl
40.9 x 44.6 x 2.00
