Traiserdinger/Custom-PX4-Flight-Controller/Mechanical/3D Printed/Holding Battery Box Right.stl

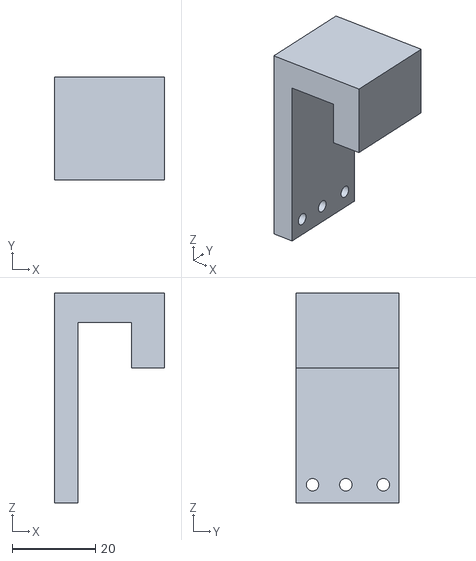
[picture p29: CAD file, 2026-11-06]
Mechanical/3D Printed/Holding Battery Box Right.stl
26.5 x 24.8 x 50.4
