Traiserdinger/Custom-PX4-Flight-Controller/Mechanical/3D Printed/HoldingPinBox.stl

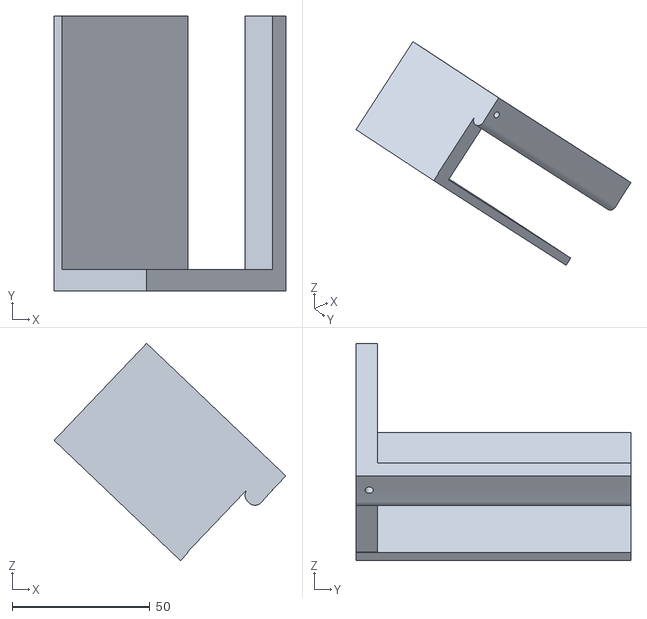
[picture p30: CAD file, 2026-11-06]
Mechanical/3D Printed/HoldingPinBox.stl
84.1 x 99.8 x 78.9
