Traiserdinger/Custom-PX4-Flight-Controller/Mechanical/3D Printed/Nửa Trên Vỏ Flight Control.stl

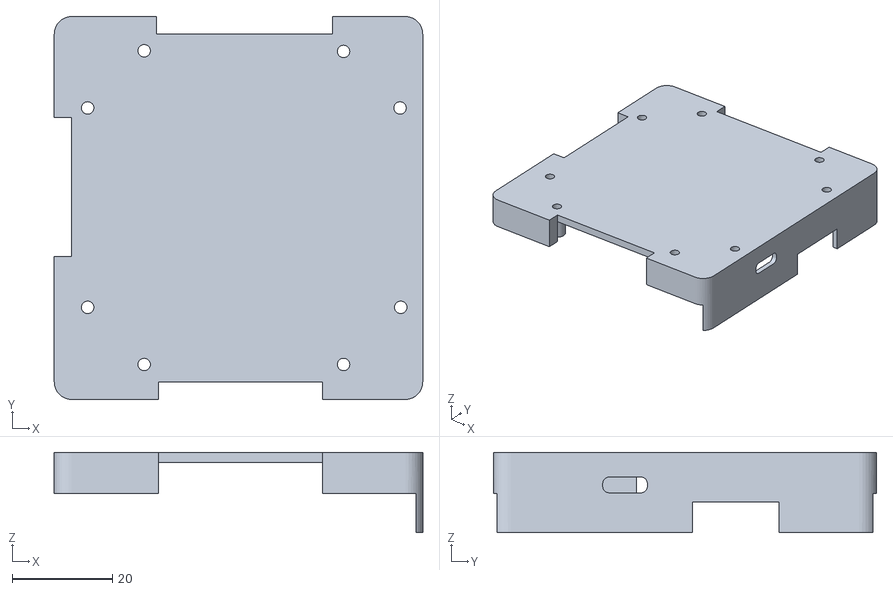
[picture p31: CAD file, 2026-11-06]
Mechanical/3D Printed/Nửa Trên Vỏ Flight Control.stl
73.7 x 76.6 x 16.0
