Traiserdinger/Custom-PX4-Flight-Controller/Mechanical/3D Printed/Nửa Dưới Vỏ Flight Control.stl

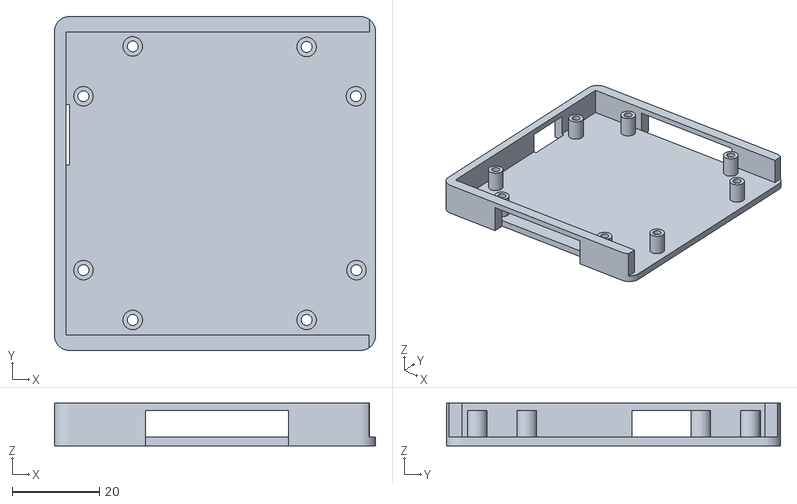
[picture p32: CAD file, 2026-11-06]
Mechanical/3D Printed/Nửa Dưới Vỏ Flight Control.stl
73.7 x 76.6 x 9.83
