Traiserdinger/Custom-PX4-Flight-Controller/Mechanical/3D Printed/rotation-lock.3mf

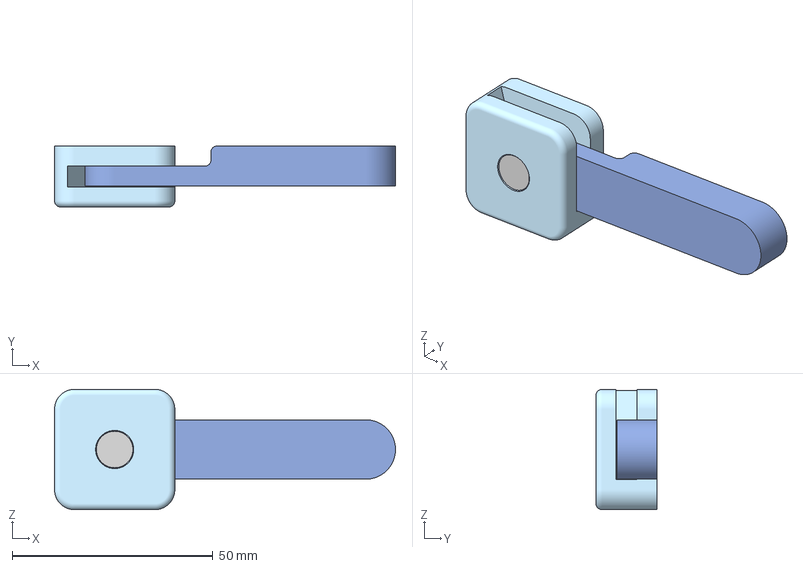
[picture p33: CAD file, 2026-11-06]
Mechanical/3D Printed/rotation-lock.3mf
85.0 x 15.2 x 30.0 mm
bar
pin
