Traiserdinger/Custom-PX4-Flight-Controller/Mechanical/3D Printed/AttachHoldingPin.stl

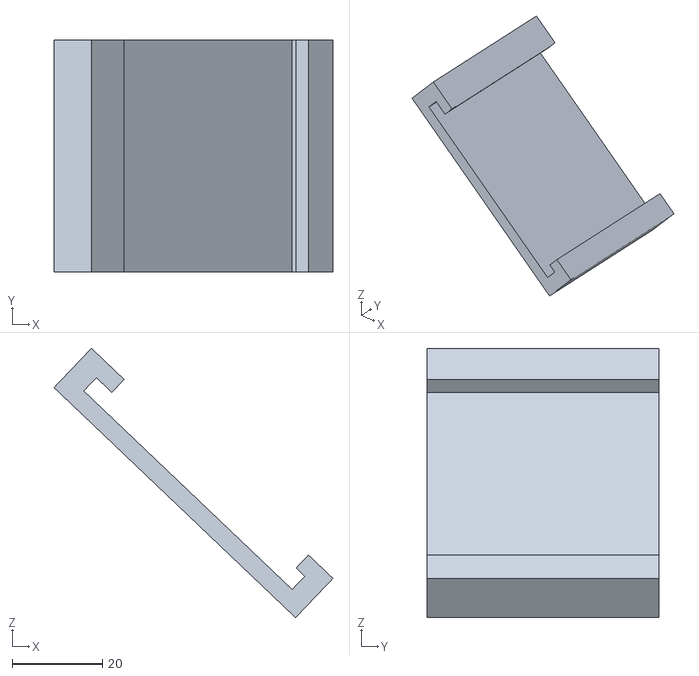
[picture p34: CAD file, 2026-11-06]
Mechanical/3D Printed/AttachHoldingPin.stl
61.7 x 51.2 x 59.6
