Traiserdinger/Custom-PX4-Flight-Controller/Mechanical/3D Printed/LockHoldingRX.stl

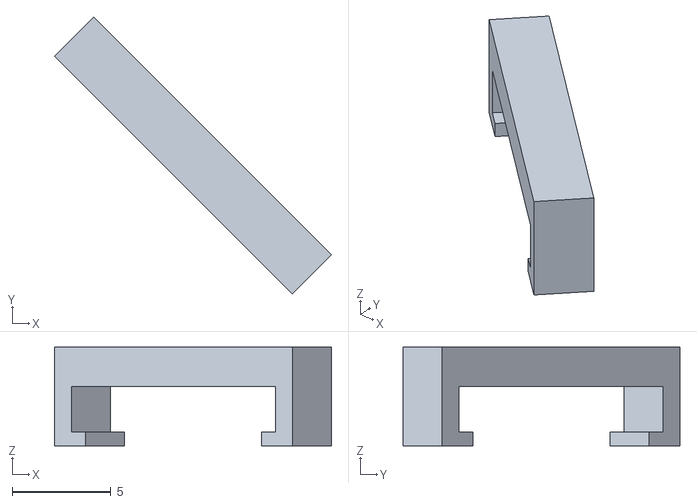
[picture p35: CAD file, 2026-11-06]
Mechanical/3D Printed/LockHoldingRX.stl
14.0 x 14.0 x 5.00
