Traiserdinger/Custom-PX4-Flight-Controller/Mechanical/3D Printed/Trung PX4 Flight Controller PCB.step

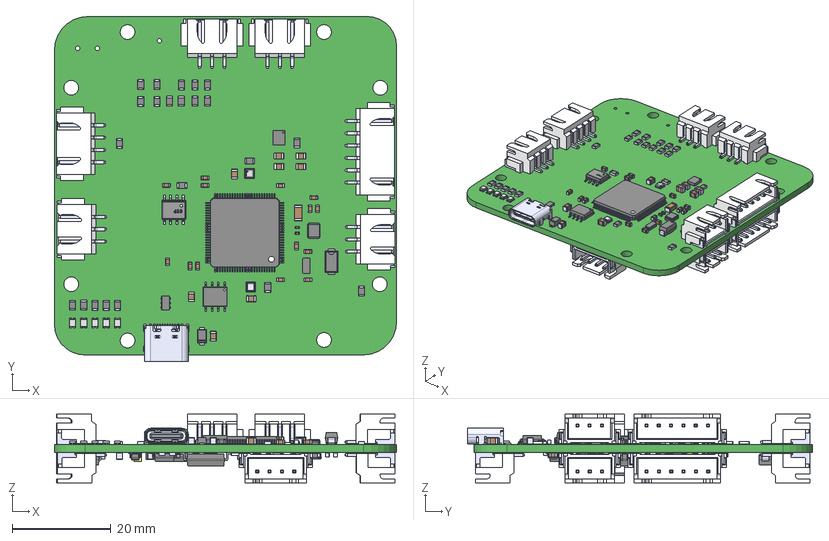
[picture p36: CAD file, 2026-11-06]
Mechanical/3D Printed/Trung PX4 Flight Controller PCB.step
69.5 x 70.0 x 14.0 mm
