Traiserdinger/Custom-PX4-Flight-Controller/Mechanical/3D Printed/glorious_curcan.stl

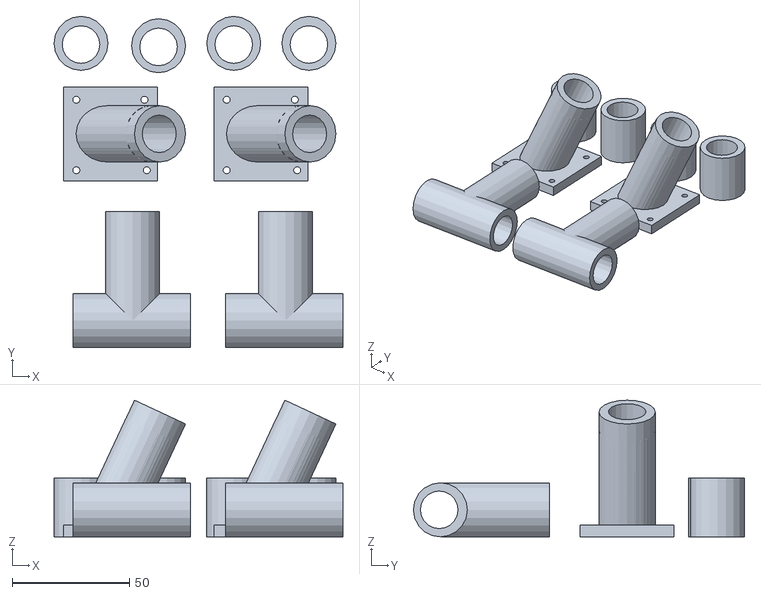
[picture p37: CAD file, 2026-11-06]
Mechanical/3D Printed/glorious_curcan.stl
123.0 x 141.0 x 58.2
