Traiserdinger/Custom-PX4-Flight-Controller/Mechanical/3D Printed/Holding Battery Box Left.stl

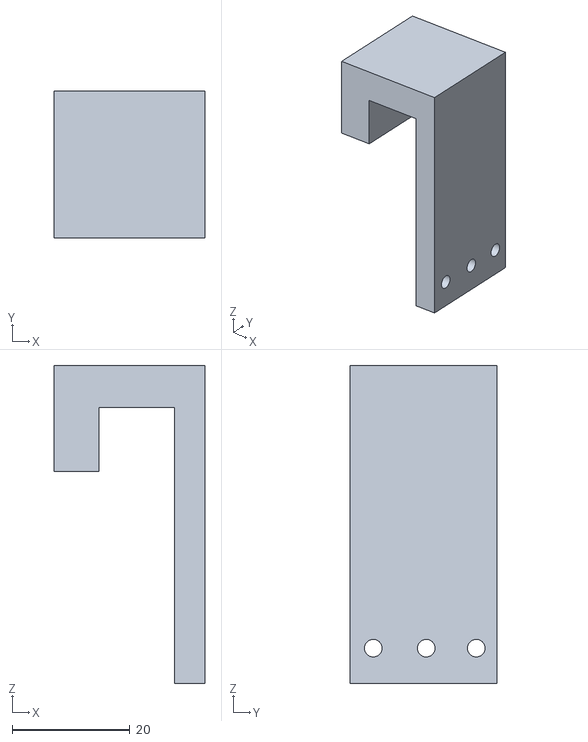
[picture p38: CAD file, 2026-11-06]
Mechanical/3D Printed/Holding Battery Box Left.stl
25.6 x 25.0 x 54.0
