Traiserdinger/Custom-PX4-Flight-Controller/Mechanical/3D Printed/Prop_Guard_Surround_Rev_B.STL

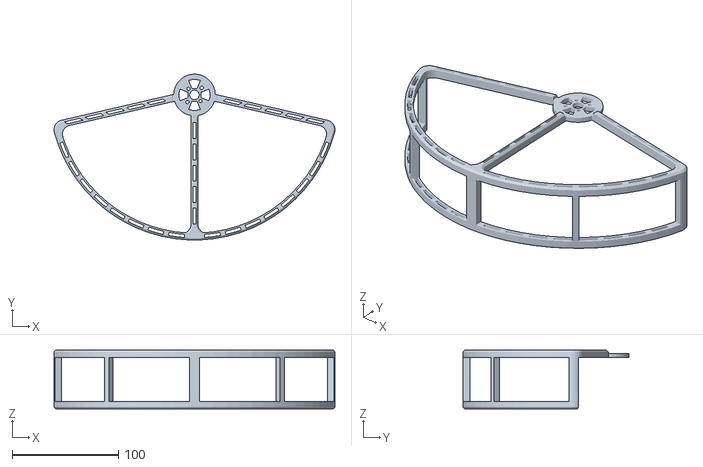
[picture p39: CAD file, 2026-11-06]
Mechanical/3D Printed/Prop_Guard_Surround_Rev_B.STL
264.1 x 155.9 x 55.1
