Traiserdinger/Custom-PX4-Flight-Controller/Mechanical/3D Printed/Battery Box.stl

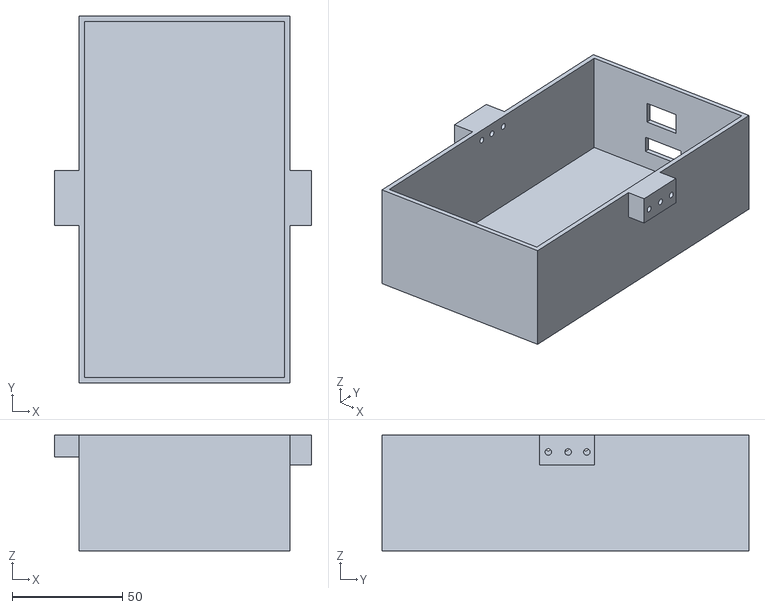
[picture p40: CAD file, 2026-11-06]
Mechanical/3D Printed/Battery Box.stl
116.7 x 166.6 x 52.5
