Traiserdinger/Custom-PX4-Flight-Controller/(list of files, cad)

Other CAD files:
Mechanical/3D Printed/VoGiuPDB.stl
Mechanical/3D Printed/HoldingPinBox (2).stl
