Traiserdinger/Custom-PX4-Flight-Controller/Mechanical/3D Printed/Dimensions-of-the-quadcopter-frame-F450.png

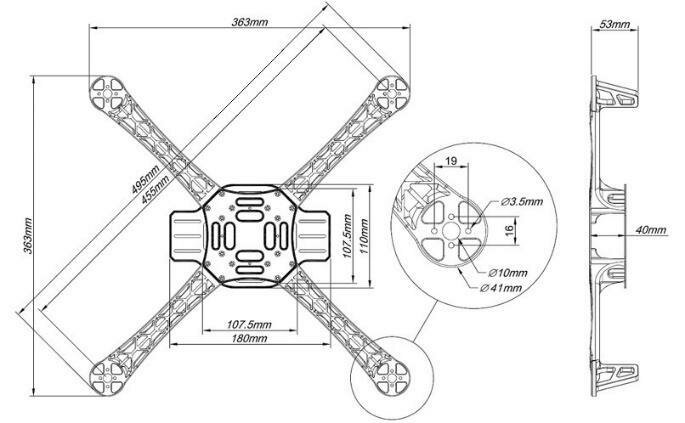
Mechanical/3D Printed/Dimensions-of-the-quadcopter-frame-F450.png
