Traiserdinger/Custom-PX4-Flight-Controller/Mechanical/3D Printed/images/9472ce8d3c65419b662e8aa889f89cc8.png

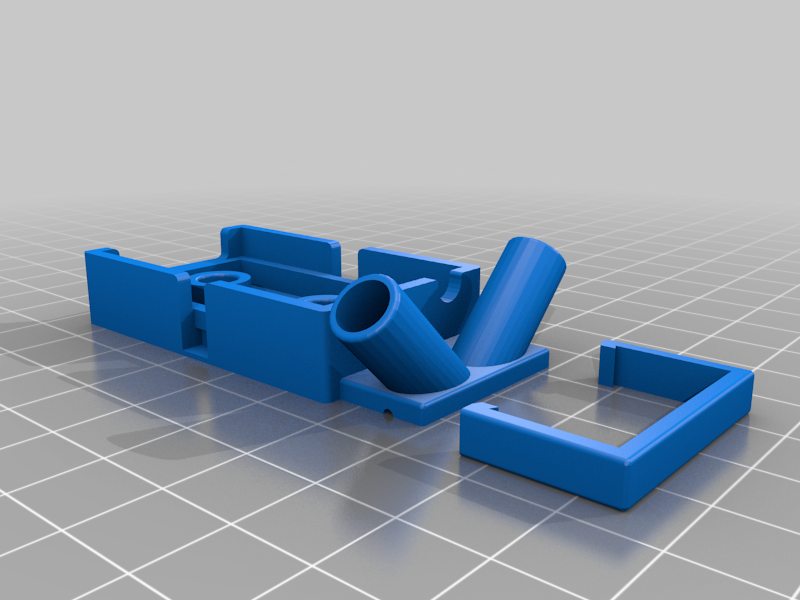
Mechanical/3D Printed/images/9472ce8d3c65419b662e8aa889f89cc8.png
