Traiserdinger/Custom-PX4-Flight-Controller/Mechanical/3D Printed/images/CIMG0676.JPG

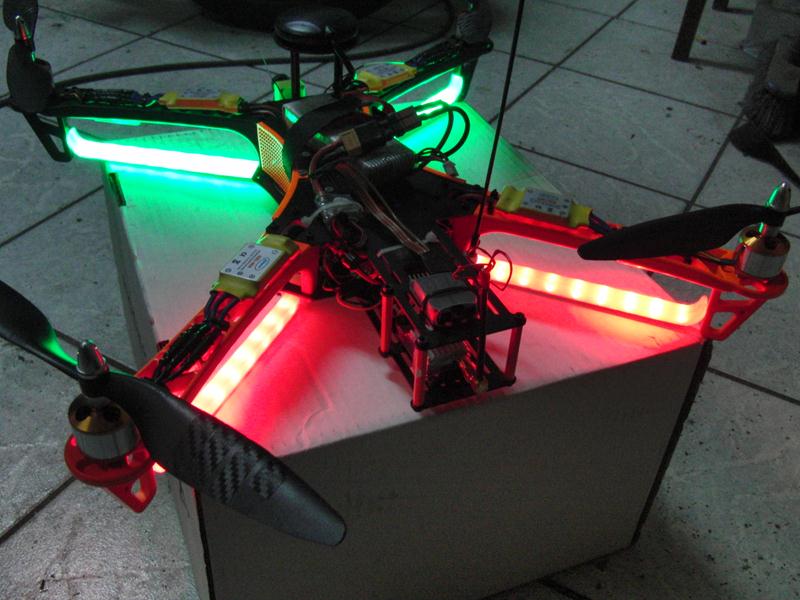
Mechanical/3D Printed/images/CIMG0676.JPG
