Traiserdinger/Custom-PX4-Flight-Controller/Mechanical/3D Printed/images/CIMG0678.JPG

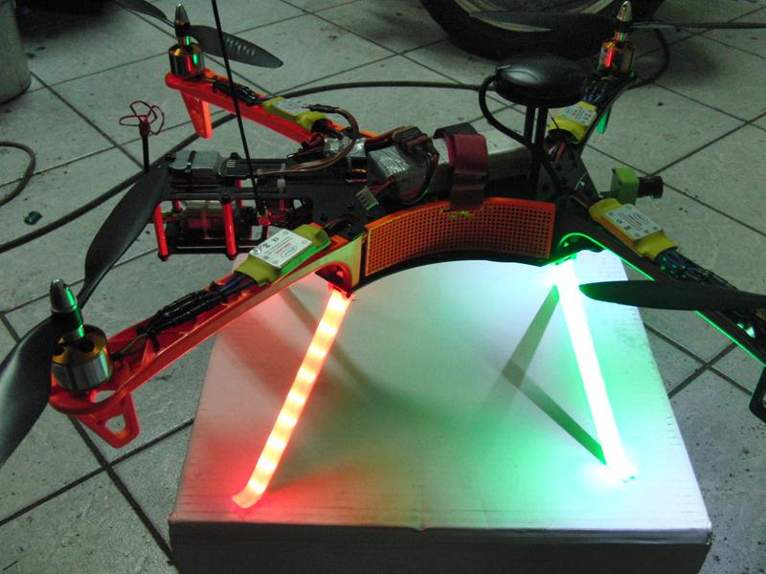
Mechanical/3D Printed/images/CIMG0678.JPG
