Traiserdinger/Custom-PX4-Flight-Controller/Mechanical/3D Printed/images/copter_nogav3.png

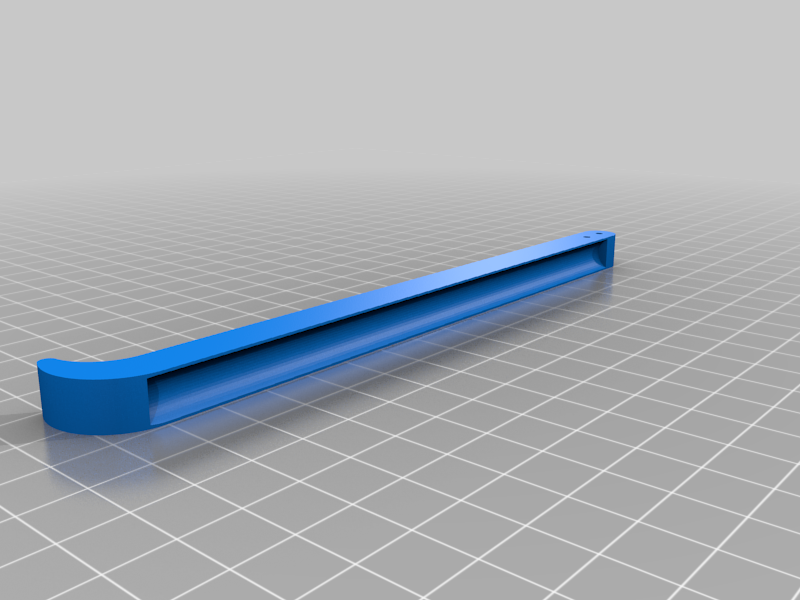
Mechanical/3D Printed/images/copter_nogav3.png
