Traiserdinger/Custom-PX4-Flight-Controller/Mechanical/3D Printed/images/copter_stopav3.png

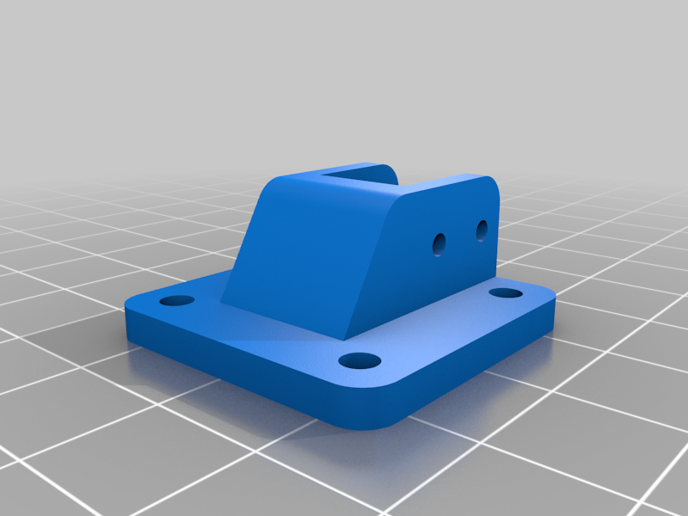
Mechanical/3D Printed/images/copter_stopav3.png
