Traiserdinger/Custom-PX4-Flight-Controller/Mechanical/3D Printed/images/dcde873161cb6575ca804ab75de2656b.png

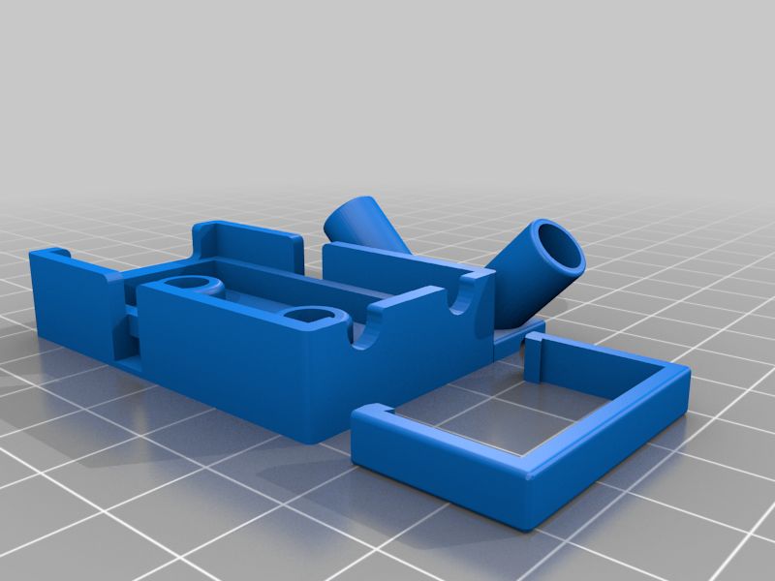
Mechanical/3D Printed/images/dcde873161cb6575ca804ab75de2656b.png
