Traiserdinger/Custom-PX4-Flight-Controller/Mechanical/3D Printed/images/djigear2.png

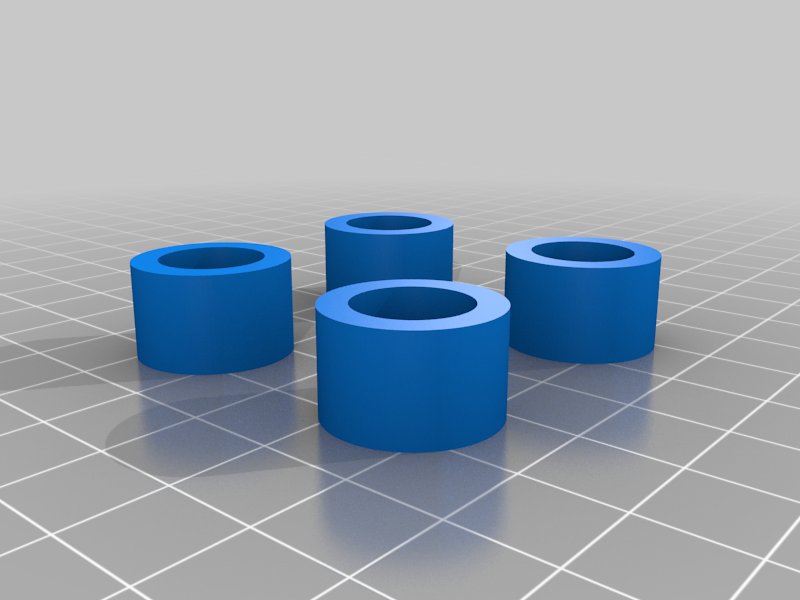
Mechanical/3D Printed/images/djigear2.png
