Traiserdinger/Custom-PX4-Flight-Controller/Mechanical/3D Printed/images/IMG_2416.JPG

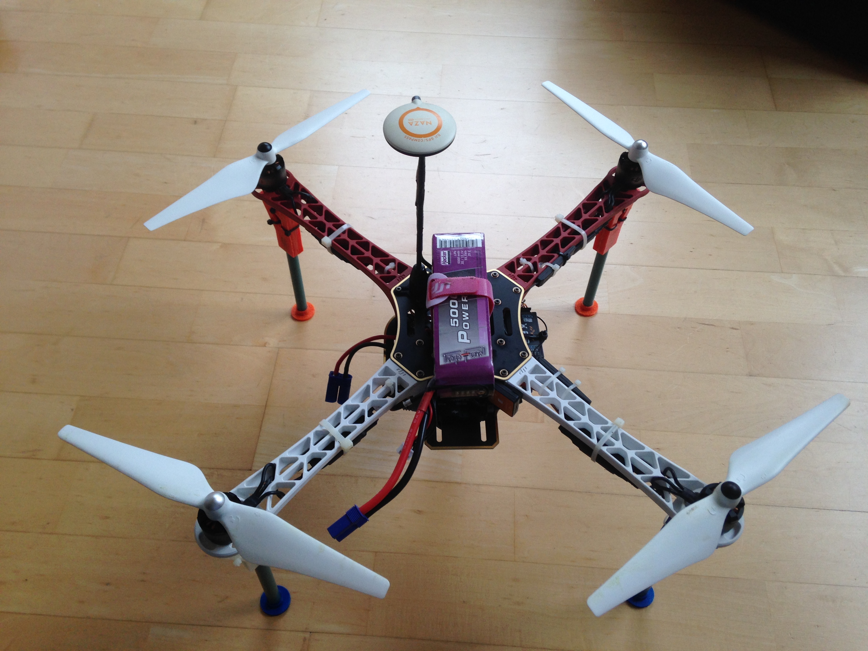
Mechanical/3D Printed/images/IMG_2416.JPG
