Traiserdinger/Custom-PX4-Flight-Controller/Mechanical/3D Printed/images/IMG_20180703_121303.jpg

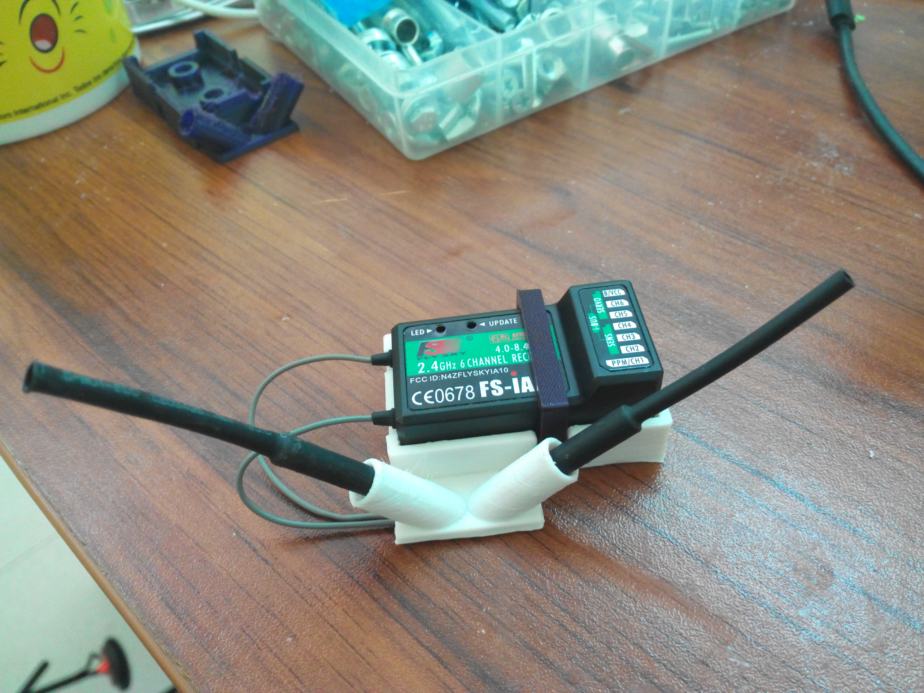
Mechanical/3D Printed/images/IMG_20180703_121303.jpg
