Traiserdinger/Custom-PX4-Flight-Controller/Mechanical/3D Printed/images/IMG_20180703_121810.jpg

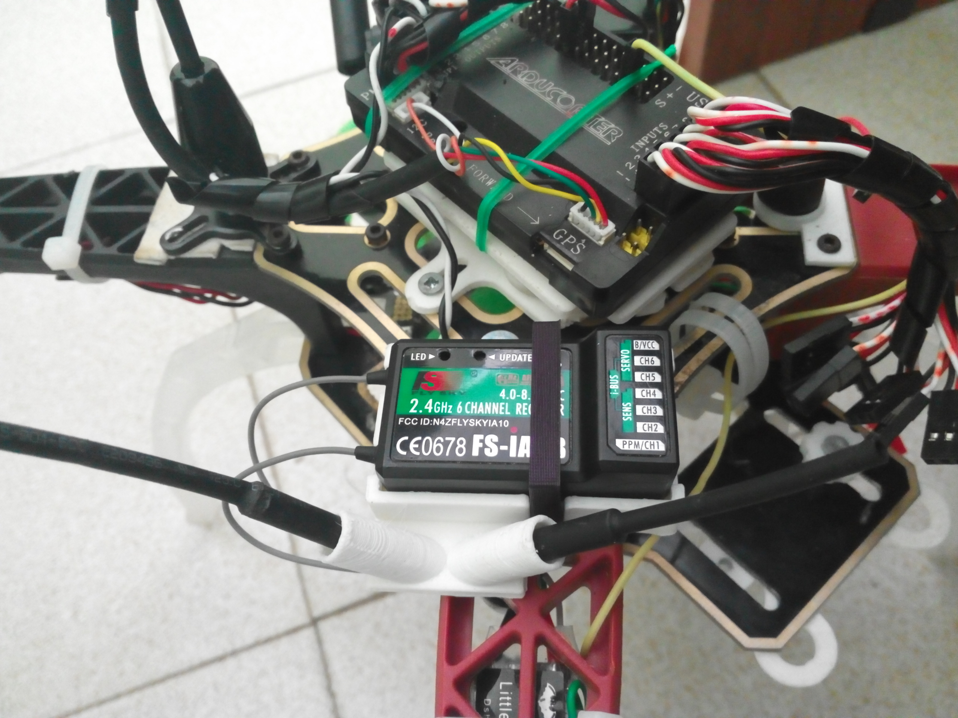
Mechanical/3D Printed/images/IMG_20180703_121810.jpg
