Traiserdinger/Custom-PX4-Flight-Controller/Mechanical/3D Printed/quadcopter frame f450-550x550w.jpg

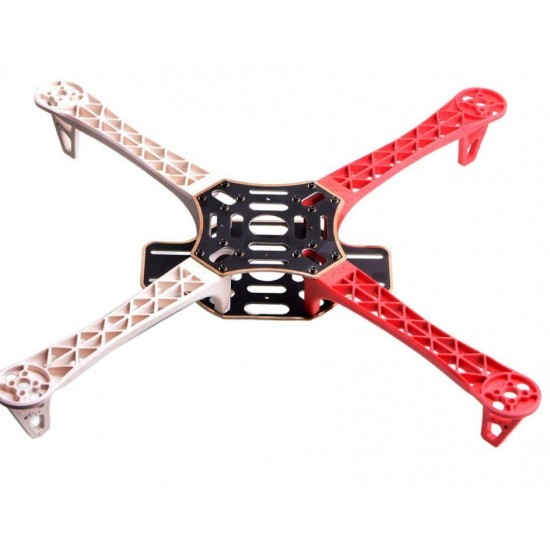
Mechanical/3D Printed/quadcopter frame f450-550x550w.jpg
