Traiserdinger/Custom-PX4-Flight-Controller/Docs/Schematic_V1.0.pdf

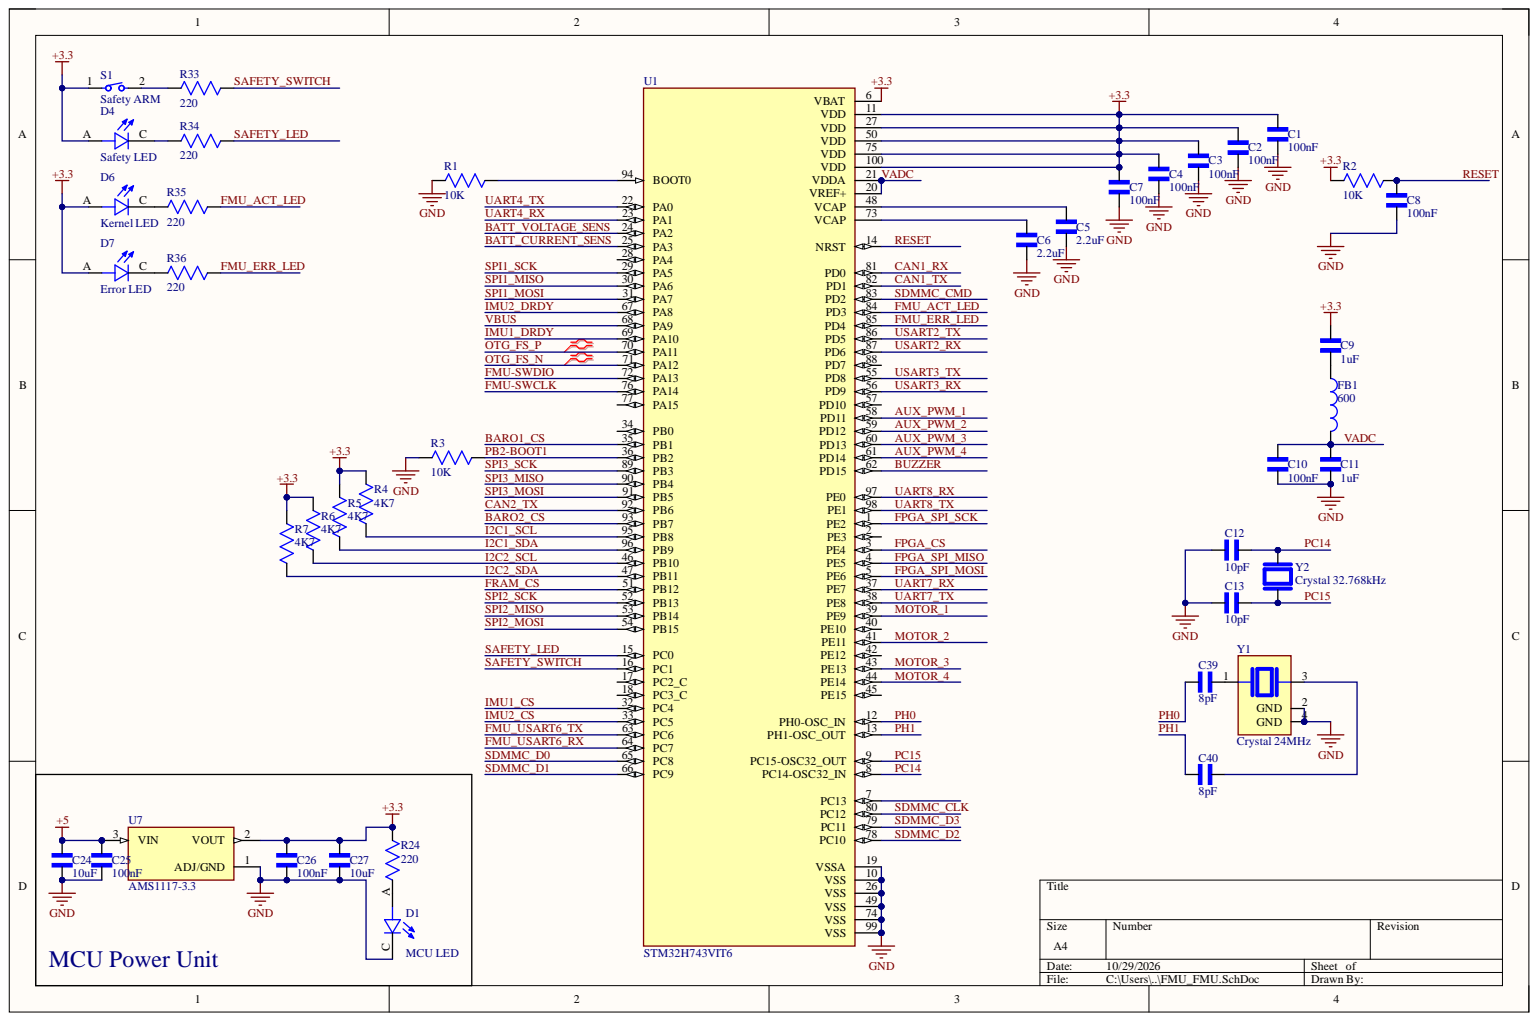
[picture p55: page 1]

2 7
5 0
7 5
1 0 0

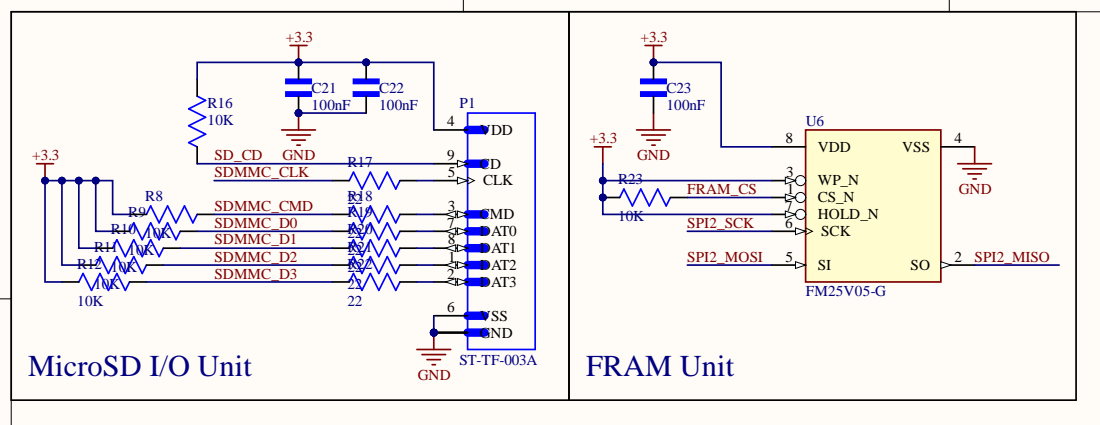
[picture p56: page 2]

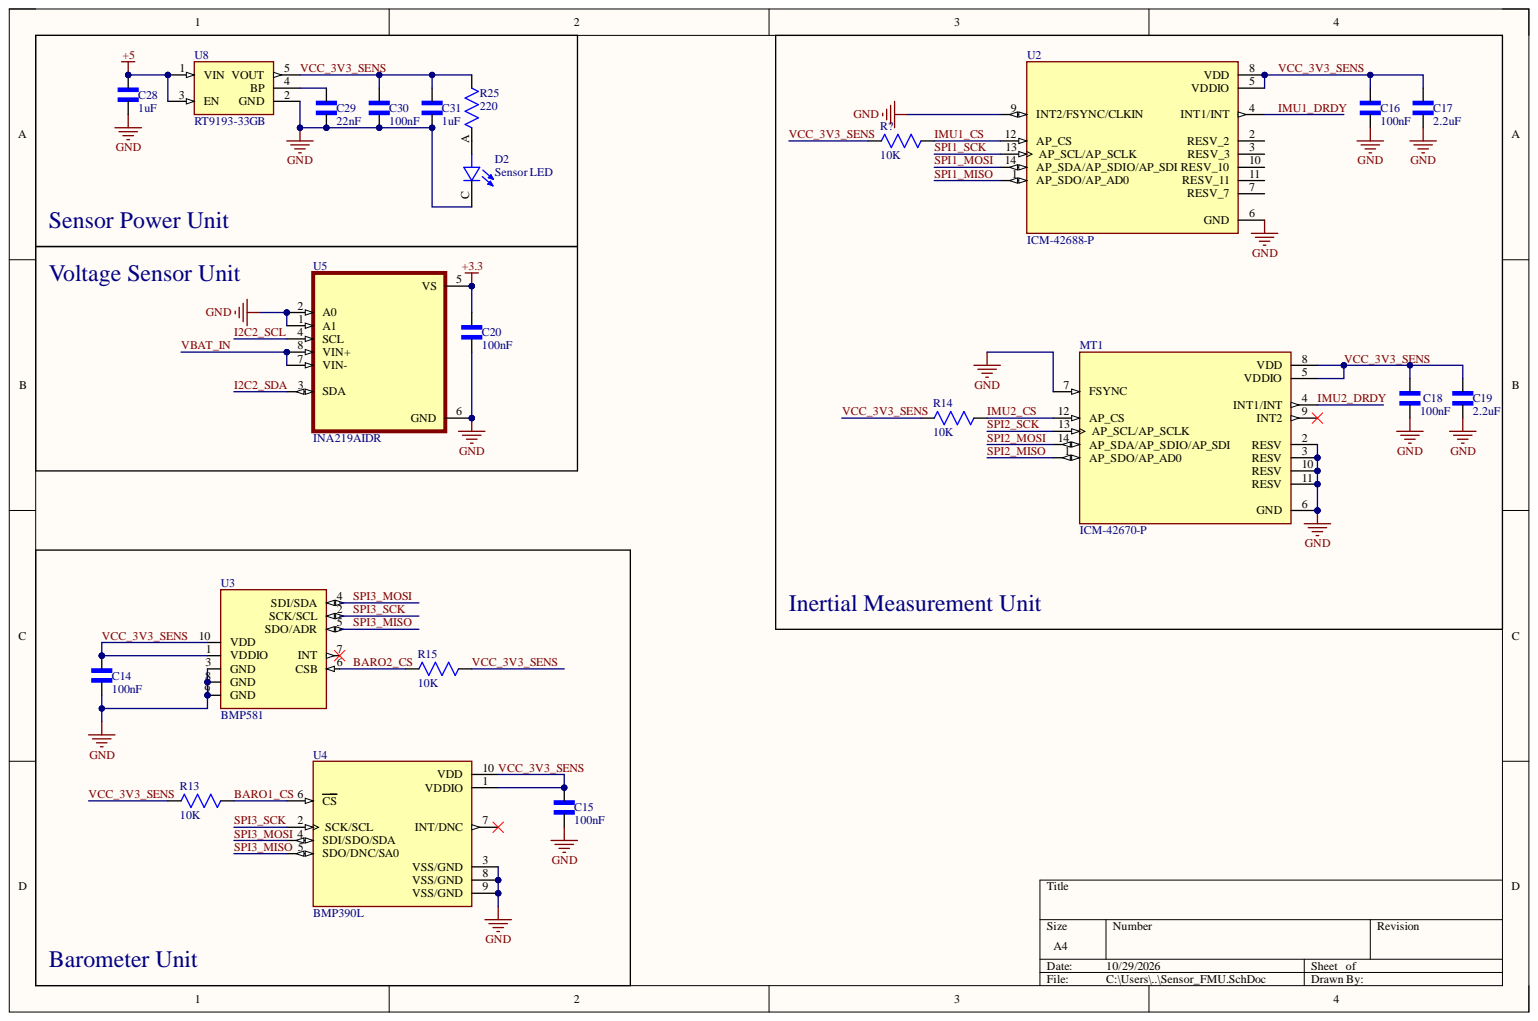
[picture p57: page 3]

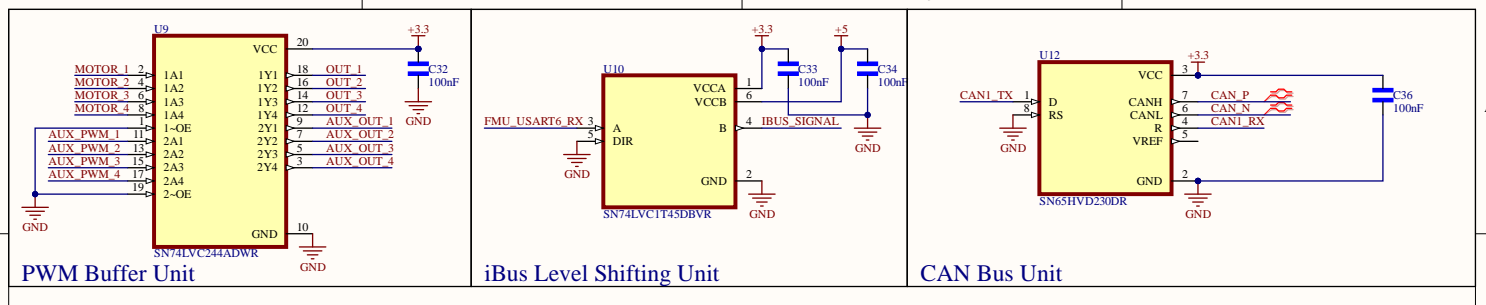
[picture p58: page 4]

iBus Level Shifting Unit

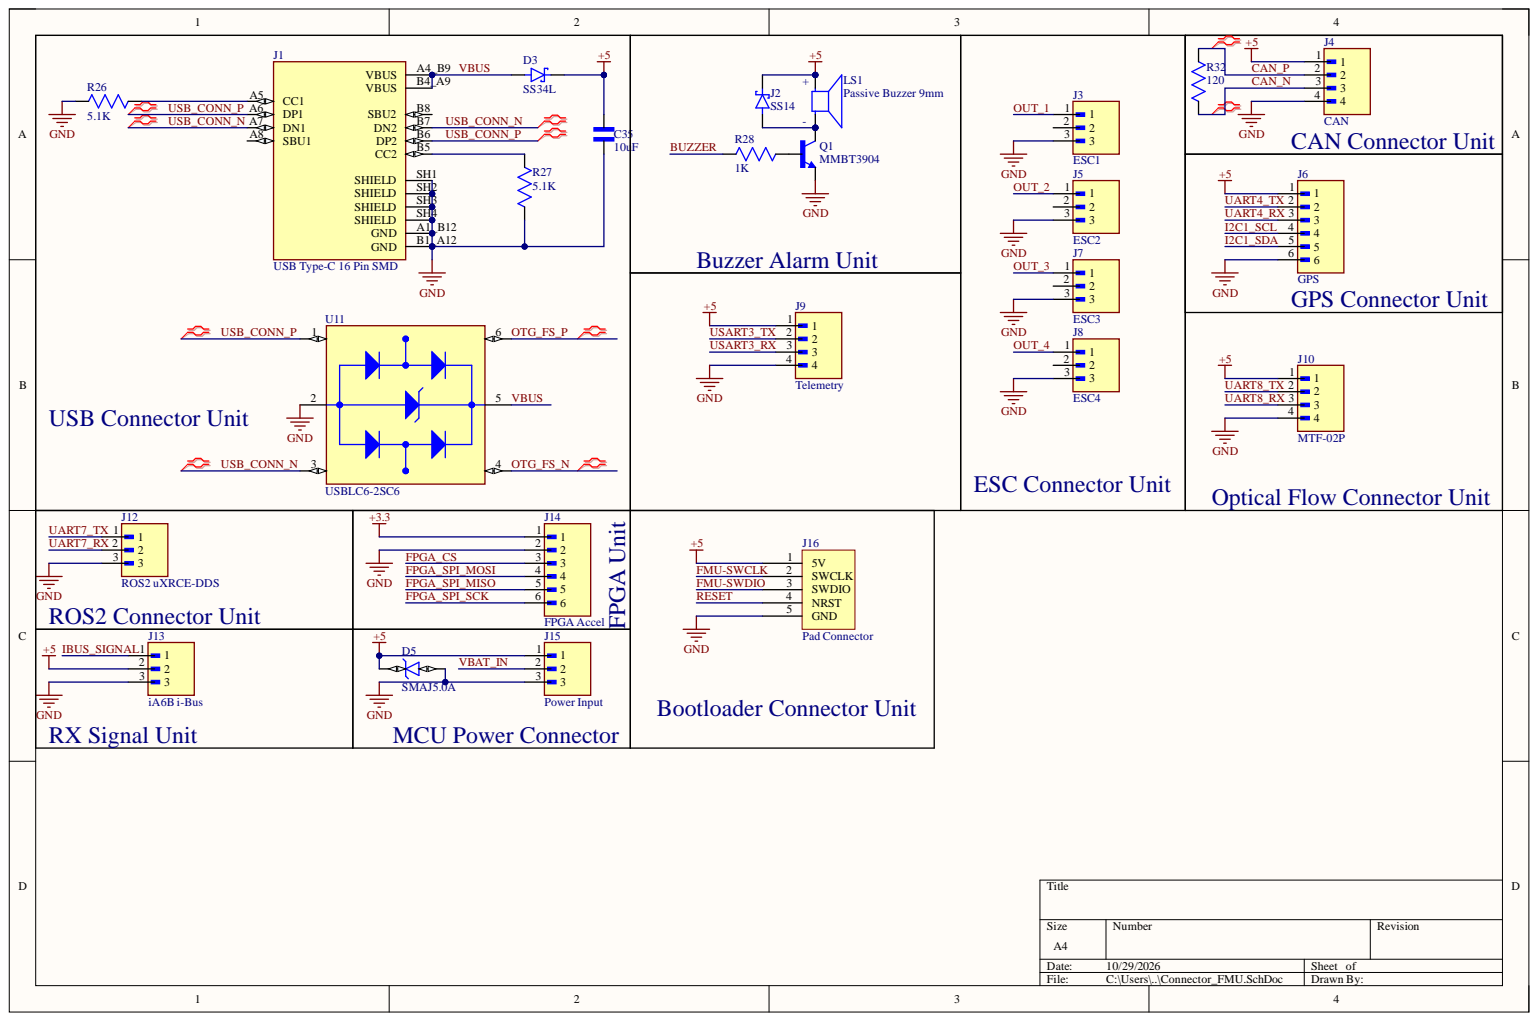
[picture p59: page 5]

Optical Flow Connector Unit

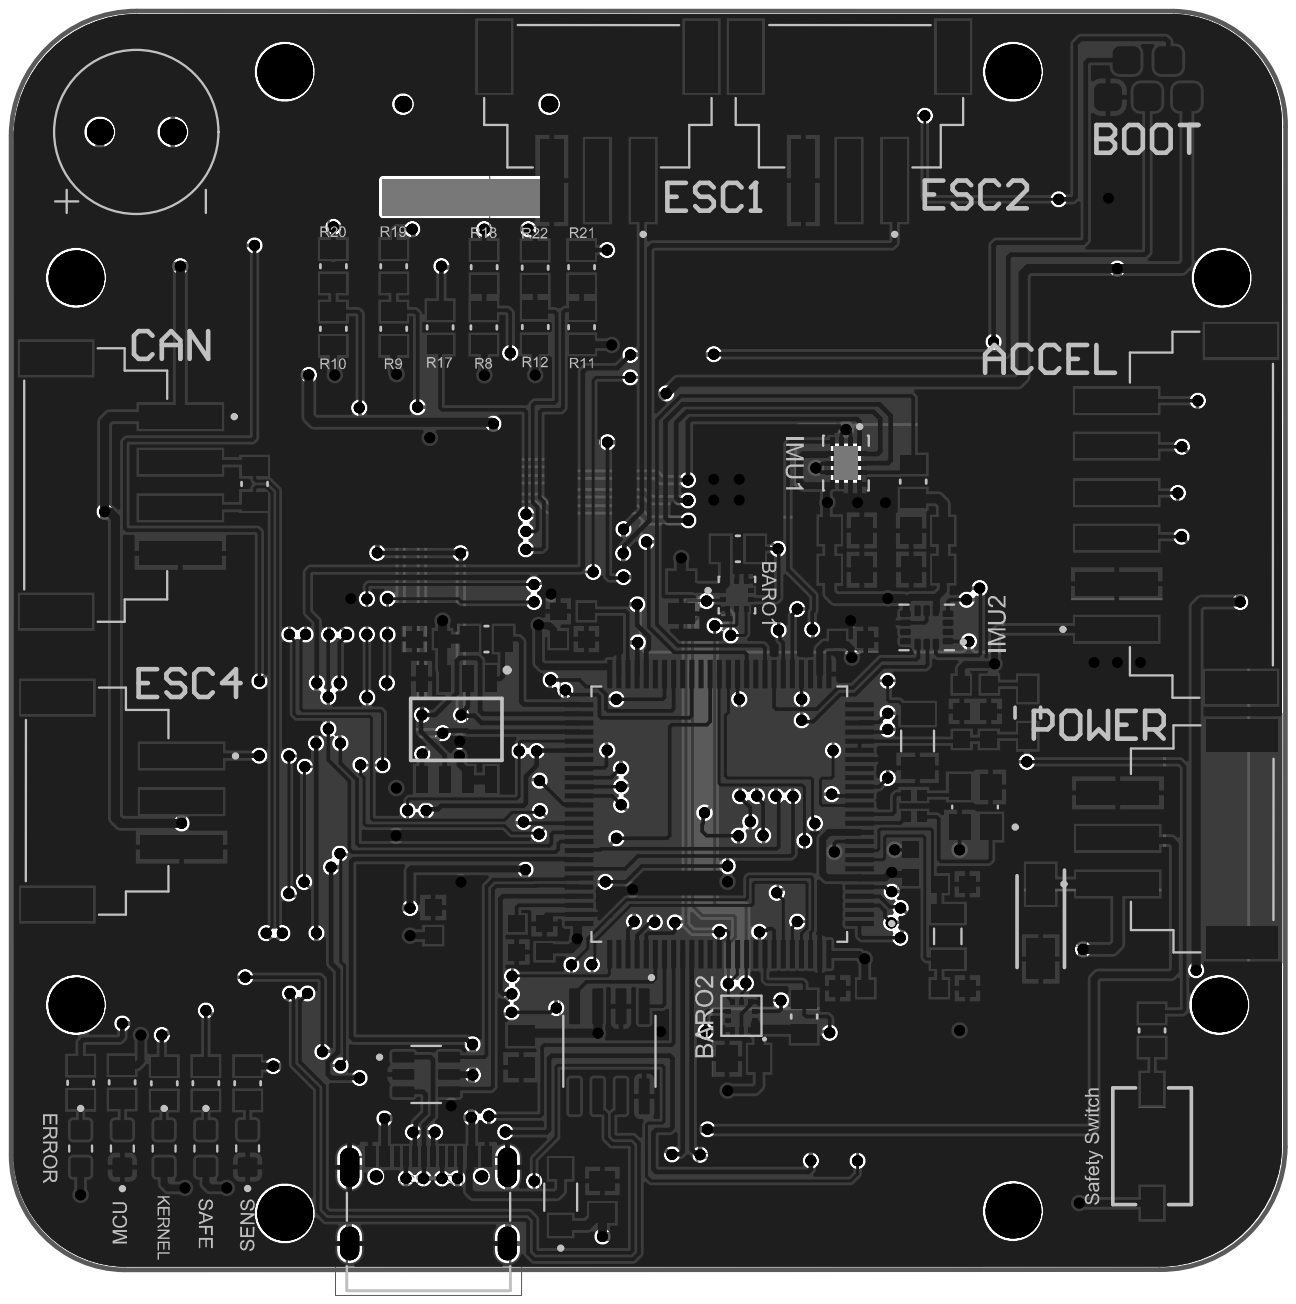
[picture p60: page 6]

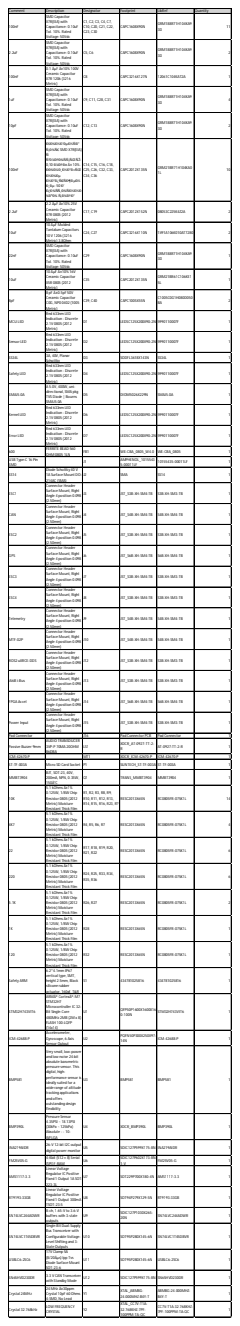
[picture p61: page 7]

2.2uF | SMD Capacitor X7R(EIA) with Capacitance: 0.10uF Tol. 10%. Rated Voltage: 50Vdc | C5, C6 | CAPC1608X90N | GRM188R71H104KA9 3D | 2

100nF | 0.1 ÂµF Â±10% 100V Ceramic Capacitor X7R 1206 (3216 Metric) | C8 | CAPC3216X127N | 12061C104KAT2A | 1

1uF | SMD Capacitor X7R(EIA) with Capacitance: 0.10uF Tol. 10%. Rated Voltage: 50Vdc | C9, C11, C28, C31 | CAPC1608X90N | GRM188R71H104KA9 3D | 4

10pF | SMD Capacitor X7R(EIA) with Capacitance: 0.10uF Tol. 10%. Rated Voltage: 50Vdc | C12, C13 | CAPC1608X90N | GRM188R71H104KA9 3D | 2

100nF | ÐšÐ¾Ð½Ð´ÐµÐ½ÑÐ° Ñ‚Ð¾Ñ€ SMD X7R(EIA) Ñ Ñ‘Ð¼ÐºÐ¾ÑÑ‚ÑŒÑŽ: 0,10 Ð¼ÐºÐ¤ Â± 10%. ÐÐ¾Ð¼Ð¸Ð½Ð°Ð»ÑŒ Ð½Ð¾Ðµ Ð½Ð°Ð¿Ñ€ÑÐ¶ÐµÐ½ Ð¸Ðµ: 50 Ð’ Ð¿Ð¾ÑÑ‚Ð¾ÑÐ½Ð½Ð ¾Ð³Ð¾ Ñ‚Ð¾ÐºÐ° | C14, C15, C16, C18, C25, C26, C32, C33, C34, C36 | CAPC2012X135N | GRM21BR71H104KA0 1L | 10

2.2uF | 2.2 ÂµF Â±10% 25V Ceramic Capacitor X7R 0805 (2012 Metric) | C17, C19 | CAPC2012X152N | 08053C225K4Z2A | 2

10uF | 10 ÂµF Molded Tantalum Capacitors 10 V 1206 (3216 Metric) 3.8Ohm | C24, C27 | CAPC3216X110N | T491A106K010AT7280 | 2

22nF | SMD Capacitor X7R(EIA) with Capacitance: 0.10uF Tol. 10%. Rated Voltage: 50Vdc | C29 | CAPC1608X90N | GRM188R71H104KA9 3D | 1

10uF | 10 ÂµF Â±10% 16V Ceramic Capacitor X5R 0805 (2012 Metric) | C35 | CAPC2012X135N | GRM21BR61C106KE1 5L | 1

8pF | 8 pF Â±0.5pF 50V Ceramic Capacitor C0G, NP0 0402 (1005 Metric) | C39, C40 | CAPC1005X55N | C1005C0G1H080D050 BA | 2

MCU LED | Red 633nm LED Indication - Discrete 2.1V 0805 (2012 Metric) | D1 | LEDSC125X200X90-2N | 5990110007F | 1

Sensor LED | Red 633nm LED Indication - Discrete 2.1V 0805 (2012 Metric) | D2 | LEDSC125X200X90-2N | 5990110007F | 1

SS34L | 3A, 40V, Planar Schottky | D3 | SODFL3618X143N | SS34L | 1

Safety LED | Red 633nm LED Indication - Discrete 2.1V 0805 (2012 Metric) | D4 | LEDSC125X200X90-2N | 5990110007F | 1

SMAJ5.0A | A 5.0V, 400W, uni-directional, SMA pkg TVS Diode | Bourns SMAJ5.0A | D5 | DIOM5026X229N | SMAJ5.0A | 1

Kernel LED | Red 633nm LED Indication - Discrete 2.1V 0805 (2012 Metric) | D6 | LEDSC125X200X90-2N | 5990110007F | 1

Error LED | Red 633nm LED Indication - Discrete 2.1V 0805 (2012 Metric) | D7 | LEDSC125X200X90-2N | 5990110007F | 1

600 | FERRITE BEAD 560 OHM 0805 1LN | FB1 | WE-CBA_0805_W4.0 | WE-CBA_0805 | 1

USB Type-C 16 Pin SMD | | J1 | AMPHENOL_1015543 5-00011LF | 10155435-00011LF | 1

SS14 | Diode Schottky 40 V 1A Surface Mount DO-214AC (SMA) | J2 | SMA | SS14 | 1

ESC1 | Connector Header Surface Mount, Right Angle 4 position 0.098 (2.50mm) | J3 | JST_S3B-XH-SM4-TB | S3B-XH-SM3-TB | 1

CAN | Connector Header Surface Mount, Right Angle 4 position 0.098 (2.50mm) | J4 | JST_S4B-XH-SM4-TB | S4B-XH-SM4-TB | 1

ESC2 | Connector Header Surface Mount, Right Angle 4 position 0.098 (2.50mm) | J5 | JST_S3B-XH-SM4-TB | S3B-XH-SM3-TB | 1

GPS | Connector Header Surface Mount, Right Angle 4 position 0.098 (2.50mm) | J6 | JST_S6B-XH-SM4-TB | S6B-XH-SM4-TB | 1

ESC3 | Connector Header Surface Mount, Right Angle 4 position 0.098 (2.50mm) | J7 | JST_S3B-XH-SM4-TB | S3B-XH-SM3-TB | 1

ESC4 | Connector Header Surface Mount, Right Angle 4 position 0.098 (2.50mm) | J8 | JST_S3B-XH-SM4-TB | S3B-XH-SM3-TB | 1

Telemetry | Connector Header Surface Mount, Right Angle 4 position 0.098 (2.50mm) | J9 | JST_S4B-XH-SM4-TB | S4B-XH-SM4-TB | 1

MTF-02P | Connector Header Surface Mount, Right Angle 4 position 0.098 (2.50mm) | J10 | JST_S4B-XH-SM4-TB | S4B-XH-SM4-TB | 1

ROS2 uXRCE-DDS | Connector Header Surface Mount, Right Angle 4 position 0.098 (2.50mm) | J12 | JST_S3B-XH-SM4-TB | S3B-XH-SM3-TB | 1

iA6B i-Bus | Connector Header Surface Mount, Right Angle 4 position 0.098 (2.50mm) | J13 | JST_S3B-XH-SM4-TB | S3B-XH-SM3-TB | 1

FPGA Accel | Connector Header Surface Mount, Right Angle 4 position 0.098 (2.50mm) | J14 | JST_S6B-XH-SM4-TB | S6B-XH-SM4-TB | 1

Power Input | Connector Header Surface Mount, Right Angle 4 position 0.098 (2.50mm) | J15 | JST_S3B-XH-SM4-TB | S3B-XH-SM3-TB | 1

Pad Connector Passive Buzzer 9mm | AUDIO TRANSDUCER 3VP-P 70MA 20OHM 86DBA | J16 LS1 | Pad Connector PCB XDCR_AT-0927-TT-2-R | Pad Connector AT-0927-TT-2-R | 1 1

ICM-42670-P | | MT1 | XDCR_ICM-42670-P | ICM-42670-P | 1

ST-TF-003A | Micro SD Card Socket | P1 | SUNTECH_ST-TF-003A | ST-TF-003A | 1

MMBT3904 | BJT, SOT-23, 40V, 200mA, NPN, 0.35W, 150Â°C | Q1 | TRANS_MMBT3904 | MMBT3904 | 1

10K | 5.1 kOhms Â±1% 0.125W, 1/8W Chip Resistor 0805 (2012 Metric) Moisture Resistant Thick Film | R1, R2, R3, R8, R9, R10, R11, R12, R13, R14, R15, R16, R23, R? | RESC2013X65N | RC0805FR-075K1L | 14

4K7 | 5.1 kOhms Â±1% 0.125W, 1/8W Chip Resistor 0805 (2012 Metric) Moisture Resistant Thick Film | R4, R5, R6, R7 | RESC2013X65N | RC0805FR-075K1L | 4

22 | 5.1 kOhms Â±1% 0.125W, 1/8W Chip Resistor 0805 (2012 Metric) Moisture Resistant Thick Film | R17, R18, R19, R20, R21, R22 | RESC2013X65N | RC0805FR-075K1L | 6

220 | 5.1 kOhms Â±1% 0.125W, 1/8W Chip Resistor 0805 (2012 Metric) Moisture Resistant Thick Film | R24, R25, R33, R34, R35, R36 | RESC2013X65N | RC0805FR-075K1L | 6

5.1K | 5.1 kOhms Â±1% 0.125W, 1/8W Chip Resistor 0805 (2012 Metric) Moisture Resistant Thick Film | R26, R27 | RESC2013X65N | RC0805FR-075K1L | 2

1K | 5.1 kOhms Â±1% 0.125W, 1/8W Chip Resistor 0805 (2012 Metric) Moisture Resistant Thick Film | R28 | RESC2013X65N | RC0805FR-075K1L | 1

120 | 5.1 kOhms Â±1% 0.125W, 1/8W Chip Resistor 0805 (2012 Metric) Moisture Resistant Thick Film | R32 | RESC2013X65N | RC0805FR-075K1L | 1

Safety ARM | 6.2*4.1mm IP67 vertical type, SMT, height 2.5mm, Black silicone rubber actuator, 160gf, T&R | S1 | 434781025816 | 434781025816 | 1

STM32H743VIT6 | ARMÂ® CortexÂ®-M7 STM32H7 Microcontroller IC 32-Bit Single-Core 480MHz 2MB (2M x 8) FLASH 100-LQFP (14x14) | U1 | QFP50P1600X1600X16 0-100N | STM32H743VIT6 | 1

ICM-42688-P | Accelerometer, Gyroscope, 6 Axis Sensor Output | U2 | PQFN50P300X250X97-14N | ICM-42688-P | 1

BMP581 | Very small, low-power and low noise 24-bit absolute barometric pressure sensor. This digital, high-performance sensor is ideally suited for a wide range of altitude tracking applications and offers outstanding design flexibility | U3 | BMP581 | BMP581 | 1

BMP390L | Pressure Sensor 4.35PSI ~ 18.13PSI (30kPa ~ 125kPa) Absolute - - 10-WFLGA | U4 | XDCR_BMP390L | BMP390L | 1

INA219AIDR | 26-V 12-bit I2C output digital power monitor | U5 | SOIC127P599X175-8N | INA219AIDR | 1

FM25V05-G | 4-Kbit (512 × 8) Serial (SPI) F-RAM | U6 | SOIC127P602X173-8N-1-V | FM25V05-G | 1

AMS1117-3.3 | Linear Voltage Regulator IC Positive Fixed 1 Output 1A SOT-223-3L | U7 | SOT229P700X180-4N | AMS1117-3.3 | 1

RT9193-33GB | Linear Voltage Regulator IC Positive Fixed 1 Output 300mA TSOT-23-5 | U8 | SOT94P279X129-5N | RT9193-33GB | 1

SN74LVC244ADWR | 8-ch, 1.65-V to 3.6-V buffers with 3-state outputs | U9 | SOIC127P1030X265-20N | SN74LVC244ADWR | 1

SN74LVC1T45DBVR | Single-Bit Dual-Supply Bus Transceiver with Configurable Voltage-Level Shifting and 3-State Outputs | U10 | SOT95P280X145-6N | SN74LVC1T45DBVR | 1

USBLC6-2SC6 | 17V Clamp 5A (8/20Âµs) Ipp Tvs Diode Surface Mount SOT-23-6 | U11 | SOT95P280X145-6N | USBLC6-2SC6 | 1

SN65HVD230DR | 3.3 V CAN Transceiver with Standby Mode | U12 | SOIC127P599X175-8N | SN65HVD230DR | 1

Crystal 24MHz | 24 MHz Â±30ppm Crystal 10pF 60 Ohms 4-SMD, No Lead | Y1 | XTAL_ABM8G-24.000MHZ-B4Y-T | ABM8G-24.000MHZ-B4Y-T | 1

Crystal 32.768kHz | LOW FREQUENCY CRYSTAL | Y2 | XTAL_CC7V-T1A-32.768KHZ-7PF-100PPM-TA-QC | CC7V-T1A-32.768KHZ-7PF-100PPM-TA-QC | 1
