Traiserdinger/Custom-PX4-Flight-Controller/(list of files, drawings)

Other design files:
Hardware/Connector_FMU.SchDoc
Hardware/FMU_FMU.SchDoc
Hardware/PWM_FMU.SchDoc
Hardware/SD_FMU.SchDoc
Hardware/Sensor_FMU.SchDoc
Hardware/Trung Flight Controller.PrjPcb
Hardware/Trung PX4 Flight Controller PCB.PcbDoc
